capaci-thor/Mecanismos/README.md

# Mecanismos
Resolución de un mecanismo de palancas articuladas para regular la longitud del punto de una máquina de coser.
