capaci-thor/Mecanismos/REPORTE/Proyecto Final Mecanismos.pdf

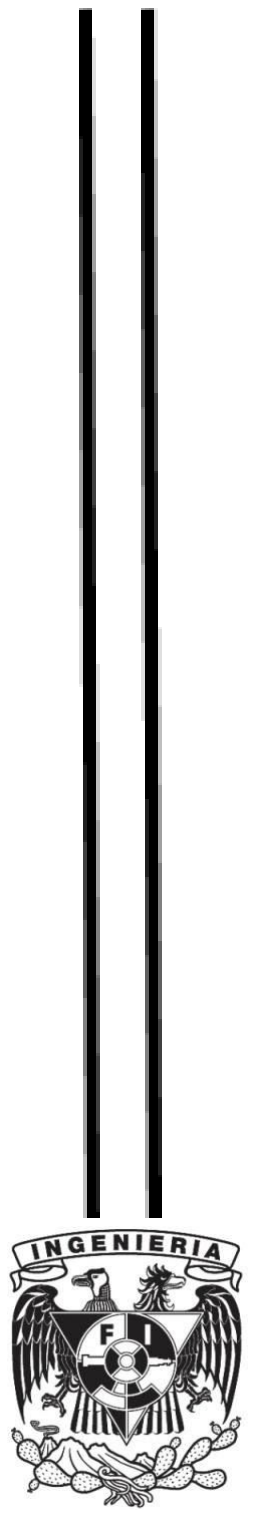
[picture p1: figure]

# Mecanismo de palancas articuladas para regular la longitud del punto de una máquina de coser

### Proyecto Final de Mecanismos

### Integrantes Ortega Trejo José Eduardo Jaimes Arriaga Donovan Zuriel

### Profesor Dr. José Antonio Silva Rico

Ciudad de México, México. 18 de junio de 2020

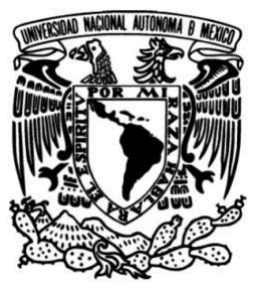
[picture p2: figure]

Objetivos

- Presentar un estudio sobre las posibles aplicaciones del mecanismo, y justificar las variables de control y las fuerzas externas
- Realización del análisis de las variables, grados de libertad e incógnitas del mecanismo.
- Desarrollo en Mathematica de un mecanismo de palancas articuladas para regular la longitud de del punto de un máquina de coser, incluyendo la solución cinemática, dinámica (Trabajo virtual y método de Newton-Euler) para todo rango de movimiento y la simulación del mecanismo.
- Realización del diseño asistido por computadora (CAD) para cada pieza que lo conforma, su ensamble y animación.

Antecedentes

La excéntrica circular 1, que gira alrededor del eje fijo A, se forma un par de rotación B con el elemento 3. El elemento 4 posee un casquillo ensanchado d que abraza la excéntrica 1. El elemento 5, que gira alrededor del eje fijo D, forma los pares de rotación E y F con los elementos 3 y 6. Los elementos 4 y 6 forman un par de rotación G. La excéntrica 1 es solidaria con el elemento 2 en la ranura b del cual puede deslizarse y fijarse la articulación B, gracias a lo cual se cambia la longitud AB. Al girar la excéntrica 1, los dientes a describen una curva de biela x si AB = AC, una curva x1 si AB > AC, y una curva x2 si AB = 0. En el último caso la longitud del punto es igual a cero.

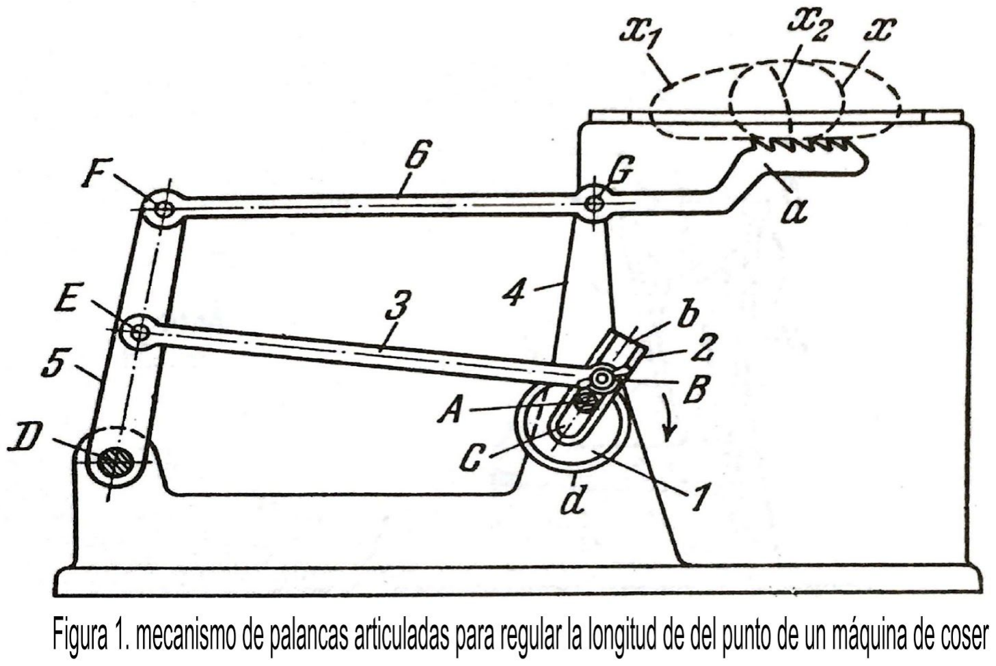
[picture p3: figure]

Para el mecanismo se puede ocupar para diferentes aplicaciones, algunas de ellas son:

- Sujetar un objeto en una posición “1” y colocarlo o pasar por la posición “2”, y esta posición puede ser variable dependiendo el objeto o la distancia a recorrer.

Ejemplos:

1. Recoger algún producto (puede ser una taza ) en la posición “1” y dejarlo en la posición “2”, la distancia entre los productos puede ser variable dependiendo la necesidad.
2. Regular la longitud de un punto de una máquina de coser.
- Otra manera de poder usar este mecanismo es poder usar las diferentes áreas variables que deja el rastro del mecanismo.

Ejemplos:

1. Pintar algún producto (puede ser una caja de cartón) que pasen de manera constante y que el área o el contorno pintado sea variable dependiendo la necesidad.
2. También se puede ver como un limpiaparabrisas que puede limpiar áreas variables para la comodidad del conductor.

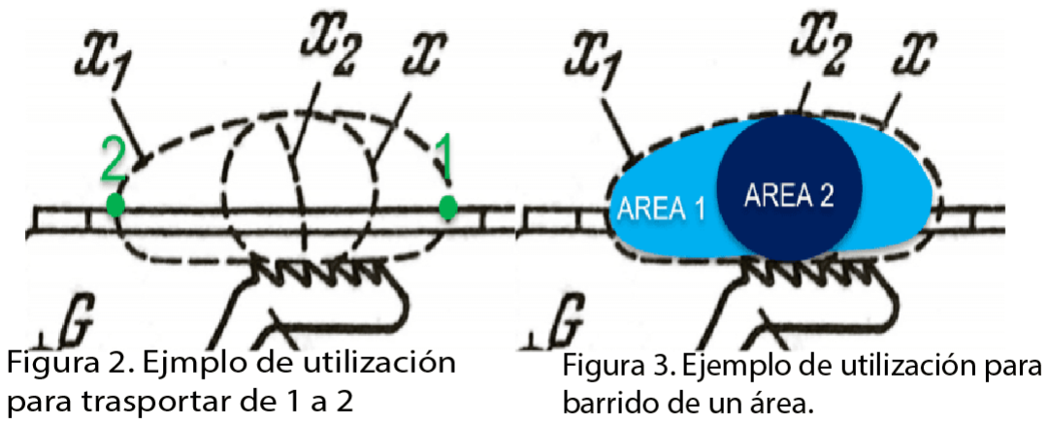
[picture p4: figure]

Para nuestro caso usaremos la aplicación que estaba propuesta desde un inicio “Mecanismo de palancas articuladas para regular la longitud del punto de una máquina de coser”.

## Desarrollo

Planteamiento

Primero se realizó el cálculo de los Grados de Libertad.

L = 6 (número total
de | eslabones,
incluyendo la tierra)

J1 = 7 (número total
de juntas completas)

J2 = 0 (número de
semijuntas)

GDL = 3*(L - 1) -
2*J1 - J2

GDL= 1.

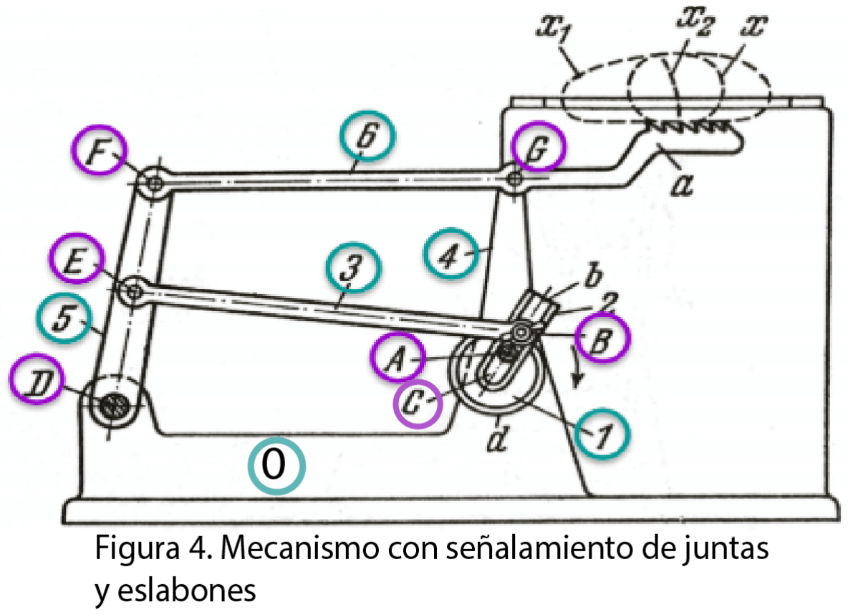
[picture p5: figure]

Como se tiene un grado de libertad, el mecanismo únicamente tiene una entrada, lo más conveniente es que ingrese un par directamente al punto A.

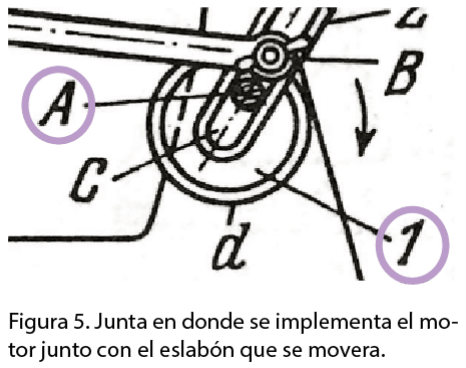
[picture p6: figure]

Para que gire el mecanismo es necesario ingresar un motor que es el que le dará todo el funcionamiento al mecanismo

## Análisis cinemático

Se realizó el lazo vectorial además del diagrama con sus respectivas variables, denotando 8 vectores de posición. Originalmente solo se tienen 7 eslabones pero se debe considerar un vector de posición más porque de no ponerlo, al momento de obtener un lazo vectorial no cerraría la trayectoria y los resultados podrían ser incongruentes.

En la Figura 6 se muestran los vectores que se tomaron en cuenta para la resolución del problema.

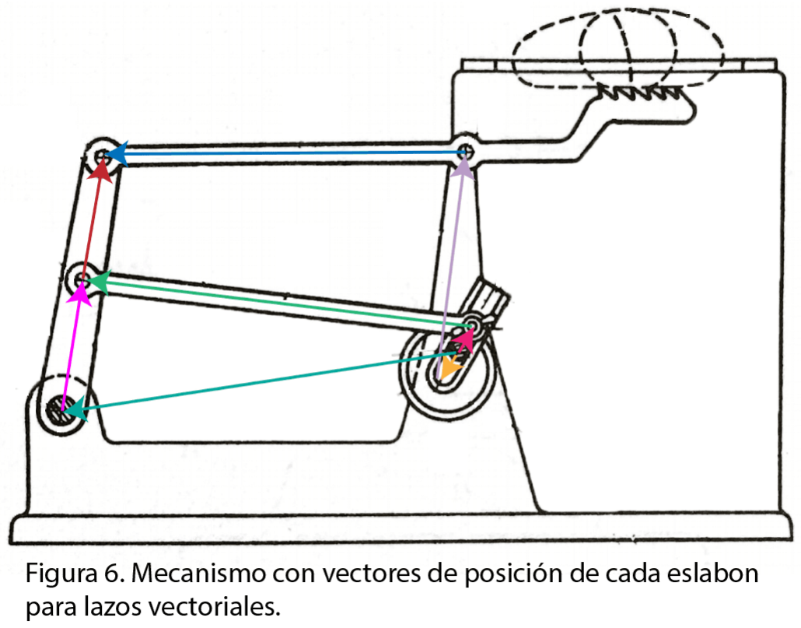
[picture p7: figure]

Se le da un nombre a cada vector para poder saber de cual se estará abordando el problema.

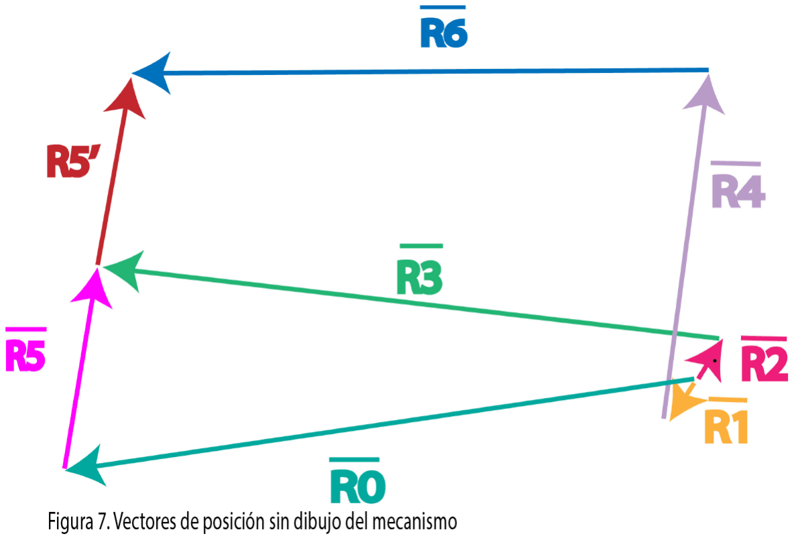
[picture p8: figure]

RO es un caso 0, ya que son vectores de magnitud y orientación fija.

R1

, R2´

, R3

, R4´

, R5

, R5

′ , R6 son caso 2, ya que son vectores de magnitud fija y orientación variable.

Obteniendo los vectores:

R | 0.13(Cos[ | + Sen[190°] ) 0 = | 190°]i

︿
j

︿

R | 0.008(Cos[ | + Sen[ | ] ) 1 = | θ | 180]i 2 +

︿
θ2 + 180 j

︿

R | 0.008(Cos[ | + Sen[ ] ) 2 = | θ ]i 2

︿
θ2

j

︿

R | 0.125(Cos[ | + Sen[ ] ) 3 = | θ ]i 3

︿
θ3

j

︿

R | 0.007(Cos[ | + Sen[ ] ) 4 = | θ ]i 4

︿
θ4

j

︿

R | 0.04 (Cos[ | + Sen[ ] ) 5 = | θ ]i 5

︿
θ5

j

︿

R | 0.04 (Cos[ | + Sen[ ] ) 5
′ = | θ ]i 5

︿
θ5

j

︿

R | 0.115(Cos[ | + Sen[ ] ) 6 = | θ ]i 6

︿
θ6

j

︿

Para la elección de los lazos vectoriales se decidió buscar caminos donde se utilizaran todos los vectores. De los vectores se tienen 5 incógnitas, sin embargo y dado al análisis en el grado de libertad se sabe que se debe de tener una variable de control, en este caso se eligió la variable θ2.

Se proponen los siguientes lazos vectoriales:

POS 1= R + | - | - 2 | R3 | R5 | RO
[1]
POS 2= R + | + | - | - | - 1 | R4 | R6 | R5
′ R3 | R2

[2]

De igual forma para la velocidad:

VEL 1= V + | - | - 2 | V 3 | V 5 | V O | [3]
VEL 2= V + | + | - | - | - 1 | V 4 | V 6 | V 5
′ V 3 | V 2

[4]

Y la aceleración:

ACE 1= A + | - | - 2 | A3 | A5 | AO | [5]
ACE 2= A + | + | - | - | - 1 | A4 | A6 | A5
′ A3 | A2

[6]

Lazo vectorial 1 formado por la ecuación [1] se muestra en la figura 8

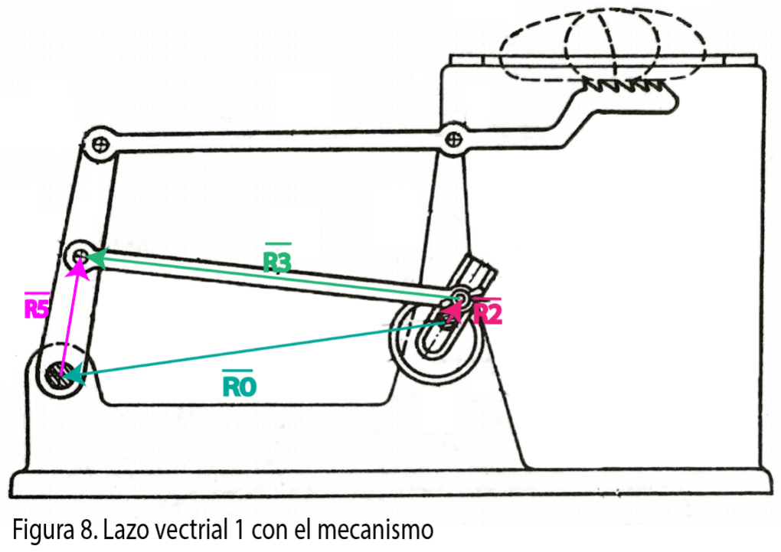
[picture p9: figure]

Lazo vectorial 2 formado por la ecuación [2] se muestra en la figura 9

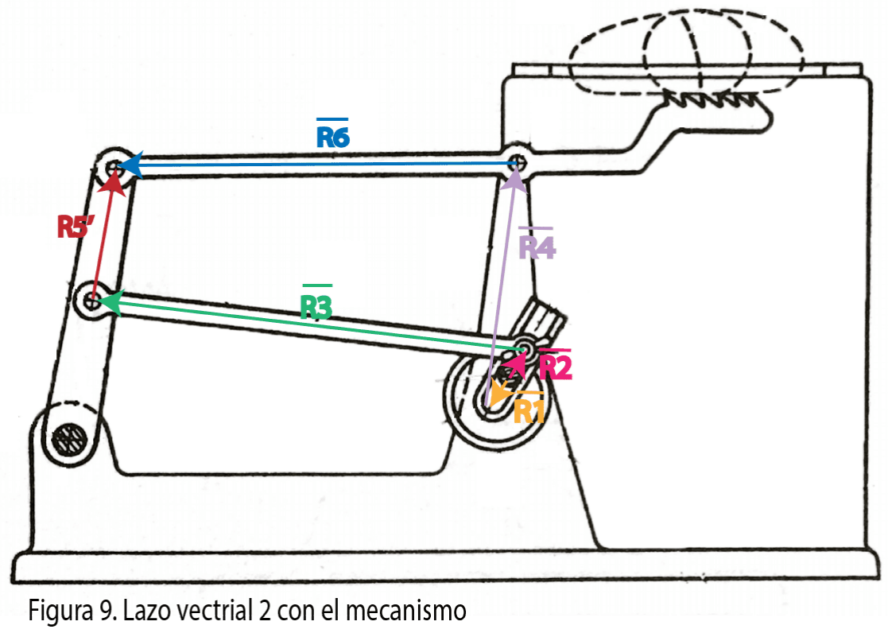
[picture p10: figure]

Por lo tanto, las incógnitas a encontrar en el sistema son: θ , | , | , 3 | θ4 | θ5 | θ6
Para la velocidad se tendrá que calcular: ω , | , | , 3 | ω4 | ω5 | ω6
Para la aceleración: α , | , | ,

´
3
α4 | α5 | α6

El método para la obtención de nuestro sistema de ecuaciones 4 x 4 se realizará con el programa Wolfram Mathematica que tiene su propio intérprete para su lenguaje de programación totalmente con total implementación para áreas científicas, de ingeniería, matemática y áreas computacionales.

Solución de posición

Wolfram Mathematica tiene un función para poder resolver sistemas de ecuaciones simultáneas no lineales, esta función se llama FindRoot, y utiliza el método numérico con newton raphson. Haciendo la implementación de este método, se necesitan valores semilla, que para este caso se proponen ángulos aproximados en los que podría estar nuestro eslabón.

Para la solución inicial, se propuso que el eslabón 2 este en un ángulo de θ = 60°, por 2 lo que para obtener todas las posibles soluciones en un giro completo del elemento A, se tomarán valores de θ con un rango de 60° a 420° 2

Para obtener la solución inicial, se tomó en cuenta un ángulo aproximado de los demás eslabones, proponiendo para la resolución:

θ = 170° 3

θ = 80° 4

θ = 80° 5

θ = 180° 6

Obteniendo una solución general para cada eslabón de:

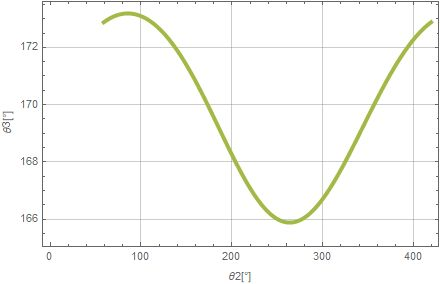
[picture p11: figure]

En la gráfica anterior se puede observar como la orientación del eslabón 3 no cambia mucho, su rango de orientación es 166 θ3 173° con diferencia de movimiento es apenas ≈7°

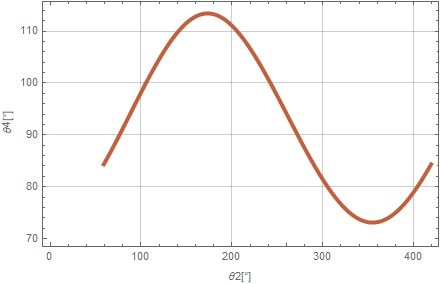
[picture p12: figure]

La gráfica del eslabón 4 se muestra el comportamiento de este oscila entre 75° θ 111°, lo que muestra que la diferencia de movimiento es apenas ≈36° 4

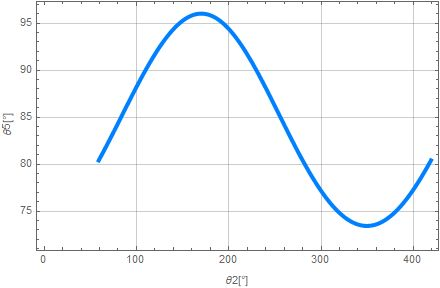
[picture p13: figure]

La gráfica del eslabón 5 nos muestra como varía su posición en un rango de 73° θ 96°, con un movimiento de ≈23° 4

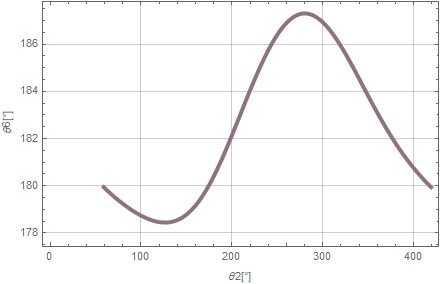
[picture p14: figure]

La gráfica del eslabón 6 nos muestra como varía su posición en un rango de 178° θ 187°, con un movimiento de ≈9° 6

El análisis de las posiciones de los eslabones nos demuestra que ningún eslabón da una vuelta completa, todos los eslabones oscilan entre un rango. El eslabón con una diferencia de movimiento mayor es de ≈ 36°.

θ | Valor Máximo [°] | Valor Mínimo [°]
θ3 | θ ≈173 cuando θ ≈90° 3 2 | θ ≈166 cuando θ ≈270° 3 2
θ4 | θ ≈75 cuando θ ≈170° 4 2 | θ ≈111 cuando θ ≈350° 4 2
θ5 | θ ≈73 cuando θ ≈170° 5 2 | θ ≈96 cuando θ ≈350° 5 2
θ6 | θ ≈178 cuando θ ≈130° 6 2 | θ ≈187 cuando θ ≈280° 6 2

Con esta tabla se puede concluir que el eslabón 3 alcanza su mayor ángulo cuando θ2 esta en su punto más alto y su menor ángulo cuando el eslabón 2 se encuentra en su menor posición. Respecto a los eslabones 4 y 5 se comportan de manera muy similar ya que alcanzan su mayor y menor ángulo casi al mismo tiempo.

Para el eslabón 6 se comporta de manera distinta a los demás, los anteriores alcanzaban sus ángulos máximos y mínimos en un rango de 180°. pero este no.

Solución de velocidad

Para la soluciones de velocidad del mecanismo,de igual manera, se propuso un valor. En este caso se eligió el valor de ω2 = 50 [rad/seg] , esto para tener una velocidad aproximada de 477.5 RPM. Wolfram Mathematica, tiene una función para resolver funciones lineales llamado Solve, puesto que se conoce ya la posición de cada eslabón se vuelve lineal, por lo tanto ahora no necesitamos un valor semilla para cada eslabón. Obteniendo las velocidades de los eslabones se tiene que:

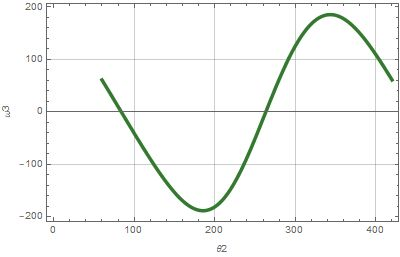
[picture p15: figure]

En la gráfica de velocidad para el eslabón 3 se puede observar como la velocidad nunca se mantiene constante, siempre esta variando pero de una forma constante, muy similar a una función sinusoidal.

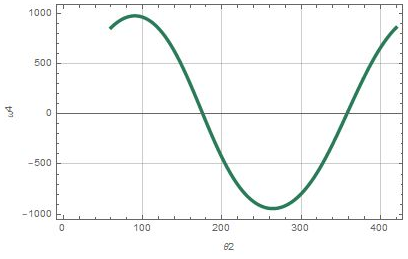
[picture p16: figure]

En la gráfica de velocidad para el eslabón 4 se puede observar como la velocidad nunca se mantiene constante, y de igual forma que el eslabón 3 se parece a una función sinusoidal pero con una amplitud mayor porque las crestas y valles se perciben más separados.

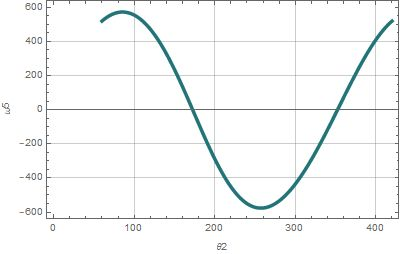
[picture p17: figure]

El eslabón 5, de la misma forma parece que proviene de una función sinusoidal por su comportamiento.

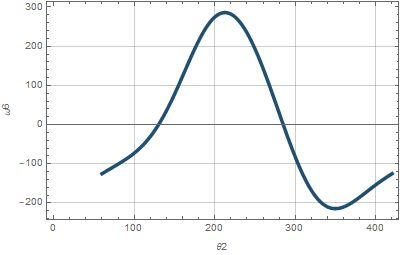
[picture p18: figure]

A diferencia de las velocidades de los eslabones 3, 4 y 5, el eslabón 6 si tiene una gran diferencia en como la velocidad cambia poco a poco y después un poco más rápido.

ω | Valor Máximo [rad/s] | Valor Mínimo [rad/s]
ω3 | ω ≈180 cuando θ ≈180° 3 2 | ω ≈ 80 cuando θ ≈340° 3 − 1 2
ω4 | ω ≈1000 cuando θ ≈90° 4 2 | ω ≈ 000 cuando θ ≈260° 4 − 1 2
ω5 | ω ≈600 cuando θ ≈90° 5 2 | ω ≈ 00 cuando θ ≈260° 5 − 6 2
ω6 | ω ≈280 cuando θ ≈210° 6 2 | ω ≈ 10 cuando θ ≈350° 6 − 2 2

Con esta tabla se puede concluir que el eslabón 3 alcanza su mayor velocidad cuando θ2 esta de manera horizontal y su menor ángulo cuando el eslabón 2 se encuentra nuevamente cerca de la horizontal.

Respecto a los eslabones 4 y 5 se comportan de manera muy similar ya que alcanzan su mayor y menor velocidad casi al mismo tiempo, y esto sucede cuando θ2 se encuentra en su mayor y menor posición.

Para el eslabón 6 en la velocidad también se comporta de manera distinta a los demás, los anteriores alcanzaban sus ángulos máximos y mínimos en un rango de 180°. pero este no.

Solución de aceleración

Para la solución de la aceleración se propuso que α2 = 0 [ rad/seg ] , debido a que lo deseable es que nuestra manivela no se acelere, esto porque entre más rápido gire, también aumentan las aceleraciones de los eslabones y por ende también las fuerzas. Si girara demasiado rápido, podrían darse deformaciones en las juntas o que simplemente se rompa. Estas ecuaciones, de igual forma resueltas en Wolfram mathematica se resuelven con la misma función Solve. Obteniendo las siguientes gráficas para todas las posiciones de θ2

, se obtienen las siguientes gráficas

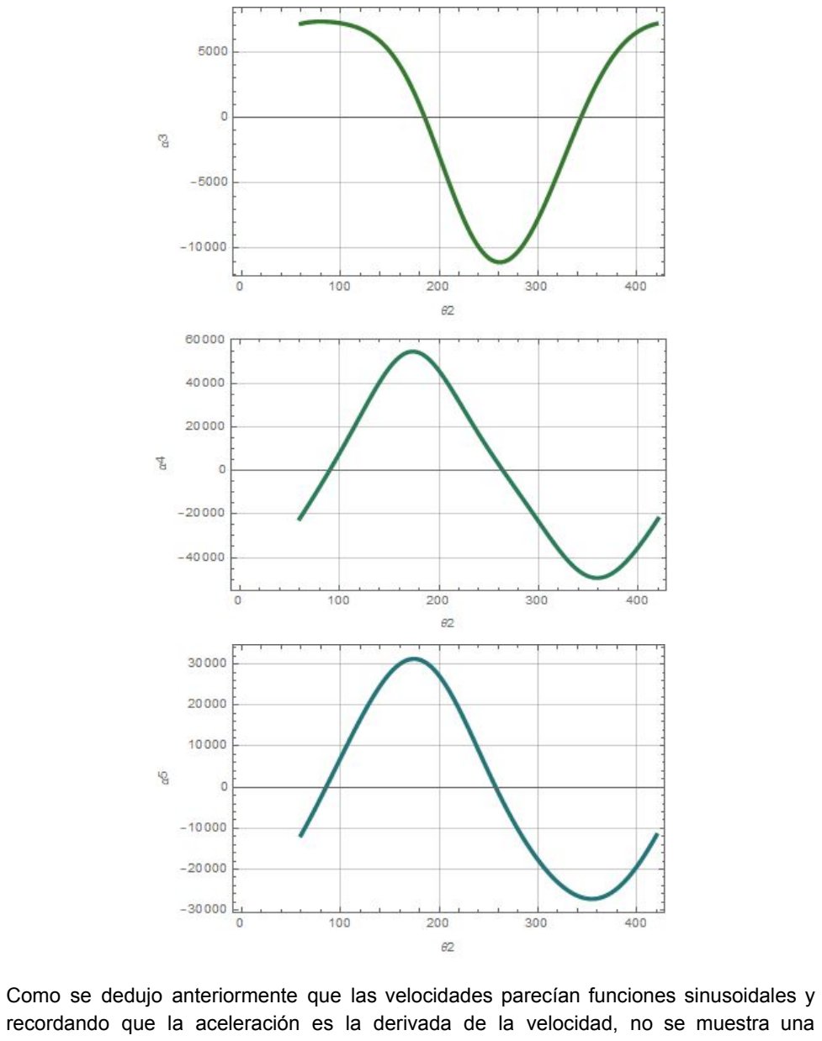
[picture p19: page 16]

Como se dedujo anteriormente que las velocidades parecían funciones sinusoidales y recordando que la aceleración es la derivada de la velocidad, no se muestra una incongruencia al mostrar que las aceleraciones de igual forma, sean funciones sinusoidales.

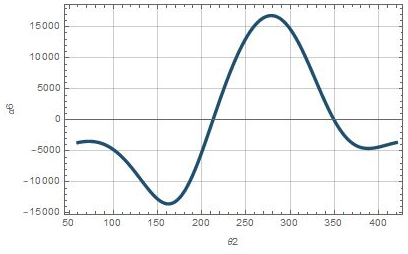
[picture p20: figure]

La aceleración del eslabón 6, es la más rara pues representada por una velocidad, que de igual forma es rara, se tiene que al principio del mecanismo se muestra una pequeña aceleración, seguido de una considerable desaceleración y después una gran aceleración que termina en una desaceleración para volver a repetir el las aceleraciones.

α | Valor Máximo [ rad ] s 2 | Valor Mínimo [ rad ] s 2
α3 | α ≈8000 cuando θ ≈90° 3 2 | α ≈ 1000 cuando θ ≈260° 3 − 1 2
α4 | α ≈55000 cuando θ ≈170° 4 2 | α ≈ 0000 cuando θ ≈360° 4 − 5 2
α5 | α ≈32000 cuando θ ≈170° 5 2 | α ≈ 6000 cuando θ ≈360° 5 − 2 2
α6 | α ≈17000 cuando θ ≈275° 6 2 | α ≈ 4000 cuando θ ≈165° 6 − 1 2

Con esta tabla se puede concluir que el eslabón 3 alcanza su mayor aceleración positiva cuando el eslabón 2 está vertical y su menor aceleración cuando el eslabón 2 se encuentra nuevamente vertical dirigido hacia abajo.

Respecto a los eslabones 4 y 5 se comportan de manera muy similar ya que alcanzan su mayor y menor aceleración casi al mismo tiempo, y esto sucede cuando el eslabón 2 se encuentra de manera horizontal.

Para el eslabón 6 en la aceleración también se comporta de manera distinta a los demás, los anteriores alcanzaban sus ángulos máximos y mínimos en un rango de 180°. pero este no.

Modelo 3D

Para el desarrollo del programa en Mathematica con el Método de Newton y el de potencia se tiene que realizar el diseño de los eslabones mediante el uso de software de diseño.

Esto debido a que para poder realizar el análisis dinámico se requiere de información como los centros de gravedad, los momentos de inercia y las masas de cada pieza.En el programa, mediante el análisis cinemático, se determinaron los parámetros como el largo de los eslabones, y sus posiciones en el espacio. Con esto se obtuvo un diseño que consistió en las siguientes piezas:

Eslabón 1:

Eslabón 2:

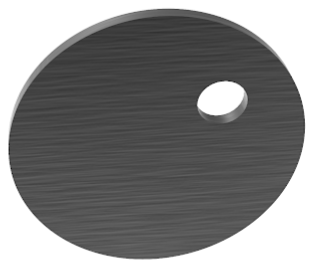
[picture p21: figure]

Eslabón 3:

Eslabón 4:

Eslabón 5:

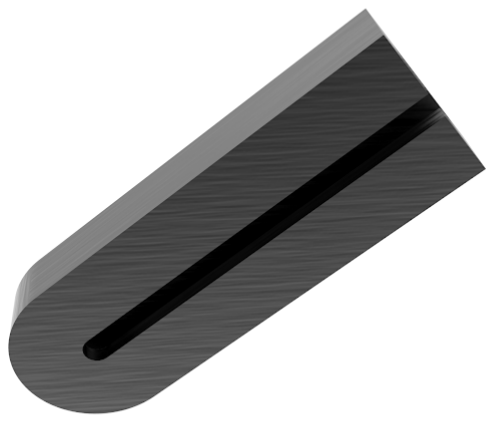
[picture p22: figure]
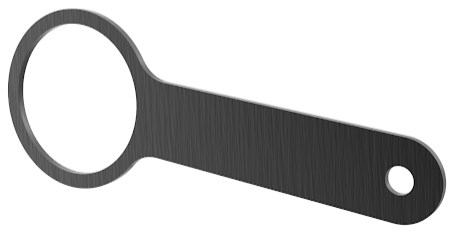
[picture p23: figure]

Eslabón 6:

Tierra :

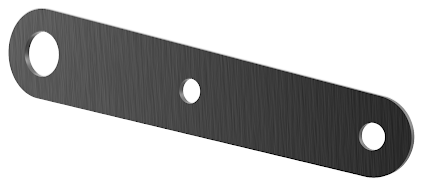
[picture p24: figure]
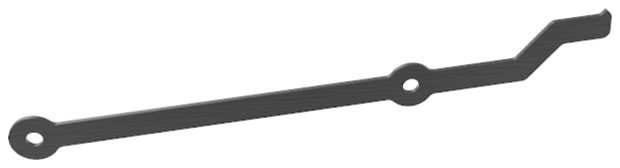
[picture p25: figure]

Ensamble:

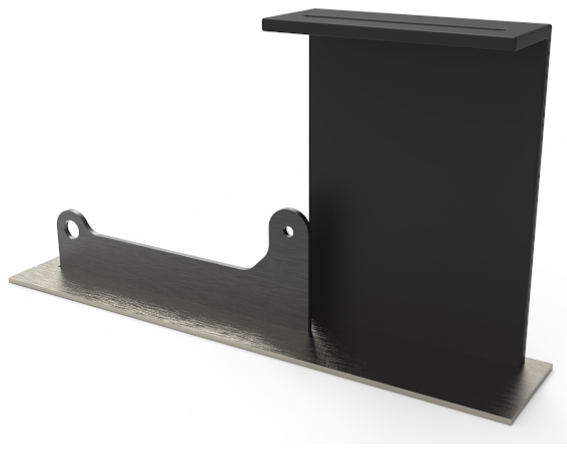
[picture p26: figure]
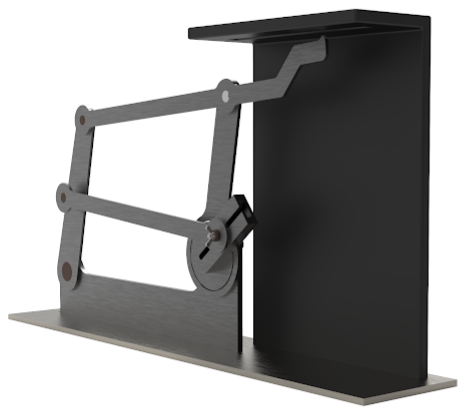
[picture p27: figure]

Análisis Dinámico

El método para el análisis dinámico requiere de información como lo son masa y momento de inercia, de los cuales se obtuvieron los siguientes datos:

Eslabón | Masa[Kg] | IG[g/mm ] 2
1y2 | 0.02772 | 8061.84
3 | 0.01433 | 25654.01
4 | 0.01402 | 10118.87
5 | 0.01824 | 13175.67
6 | 0.01917 | 72531.46

Para la obtención de los momentos de inercia en los centros de masa de cada una de las piezas, se utilizaron los valores proporcionados por Solidworks, los cuales se muestran a través de tensores. Los tensores para cada pieza se expresan de la siguiente manera:

IXX | IXY | IXZ
IYX | IYY | IYZ
IZX | IZY | IZZ

Los momentos de inercia son medidos desde el sistema de coordenadas de salida y las unidades son [ gr/mm ]. En todos los casos, todas las piezas fueron 2 diseñadas ² utilizando como referencia el plano XY, por lo tanto, el momento de inercia requerido es la componente Izz

Eslabón 1 y 2:

Eslabón 3:

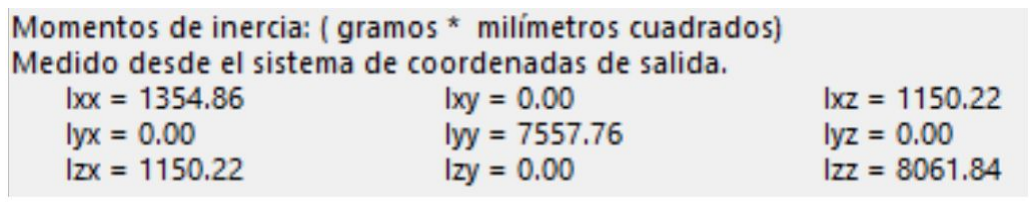
[picture p28: figure]

Eslabón 4:

Eslabón 5:

Eslabón 6:

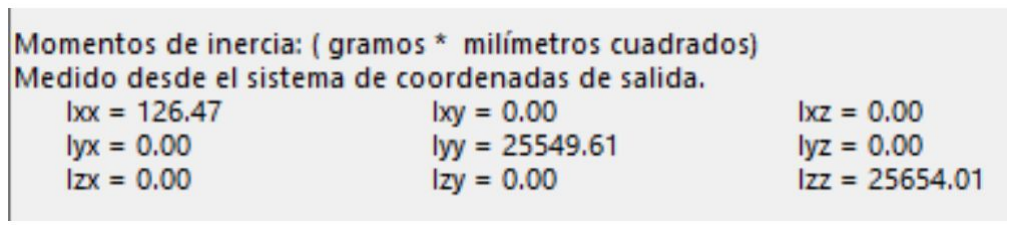
[picture p29: figure]
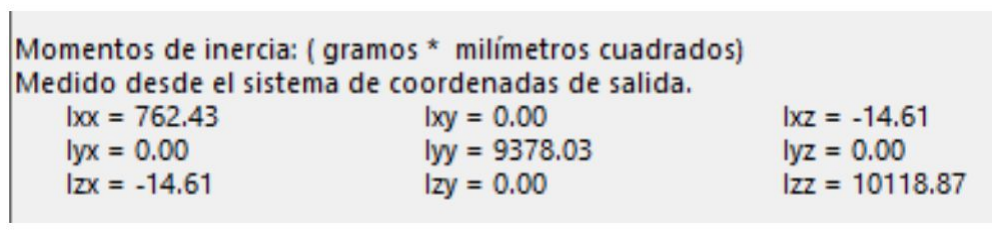
[picture p30: figure]
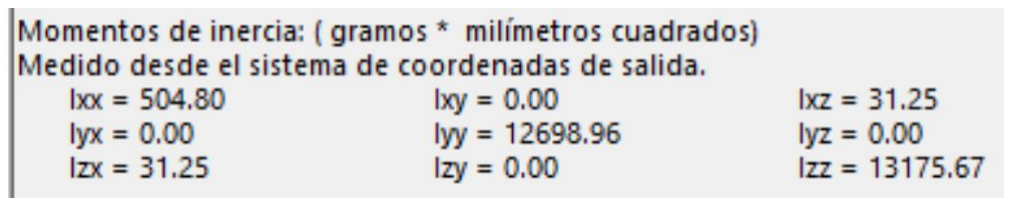
[picture p31: figure]
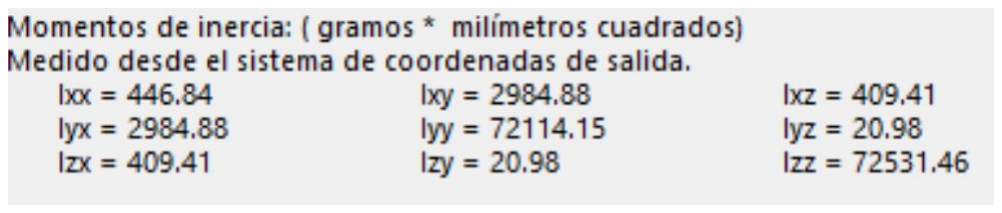
[picture p32: figure]

Cabe mencionar que los eslabones están hechos con Acero A36 pues es uno de los aceros más comunes.Por sus propiedades mecánicas, ya que siendo un mecanismo del cual no se necesita unas mayores características de resistencia mecánica, parece un material sencillo y fácil de conseguir.

Dinámica método Newton - Euler

Para la solución dinámica de newton, se necesitan los datos proporcionados anteriormente y en este caso proporcionados por el software de CAD SolidWorks. Para este método, se definieron los vectores como en la solución cinemática con la diferencia de que los vectores ya no serán de junta a junta, ahora estos vectores están definidos por un origen al centro de masa de cada eslabón.

Este método ayuda a la obtención de las fuerzas en cada eslabón, por lo tanto de las siguientes ecuaciones se deben de aplicar para cada eslabón.

∑ F = maG

∑ M α G = IG

Por lo tanto, se debe de tener un análisis completo de todas las fuerzas y pares que intervienen en cada eslabón, a continuación se presentan los diagramas de cuerpo libre de cada eslabón:

Eslabón 1 y 2:

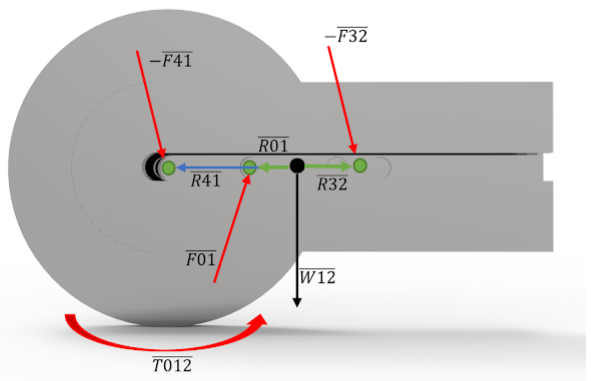
[picture p33: figure]

∑ F = − F | F | a 41 + 01 − F32 − W 12 = m12 G12
∑ M | x | x | R x F | α G = T 012 + R41 | (− F41) + R32 | (− F32) + 01 | 01 = I

G12

2

Eslabón 3:

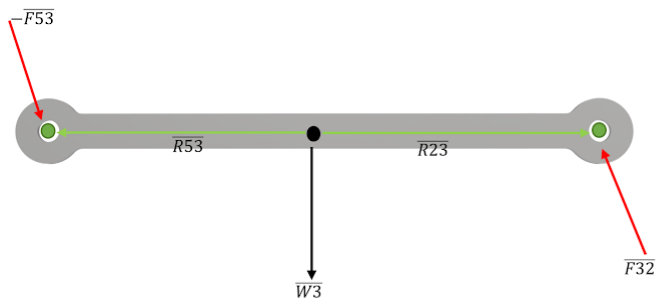
[picture p34: figure]

∑ F = − F | F | a 53 + 32 − W 3 = m3 G3
∑ M | x | R x F | α G = + R53 | (− F53) + 23 | 32 = I

G3

3

Eslabón 4:

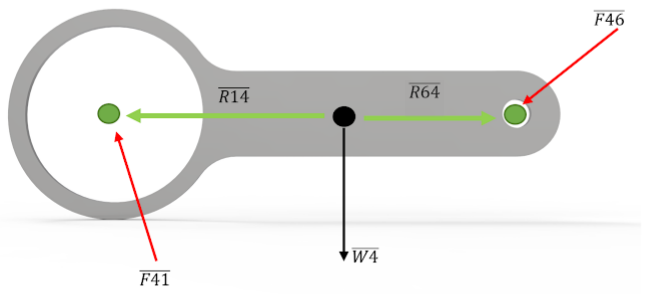
[picture p35: figure]

| ∑ F = F | | | F | a 41 + 46 − W 4 = m4 G4
∑ M | x | x | α G = + R14 | (F41) + R64 | (F46) = I

G4

4

Eslabón 5:

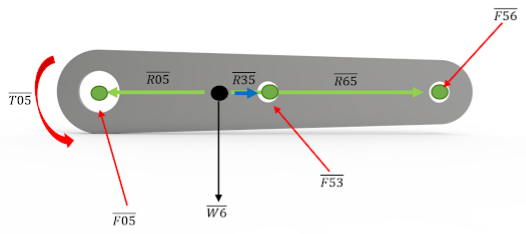
[picture p36: figure]

∑ F = + F | F | a 05 + 53 + F56 − W 5 = m5 G5
∑ M | x | x | R x F | α G = T 05 + R05 | (F05) + R35 | (F53) + 65 | 56 = I

G5

5

Eslabón 6:

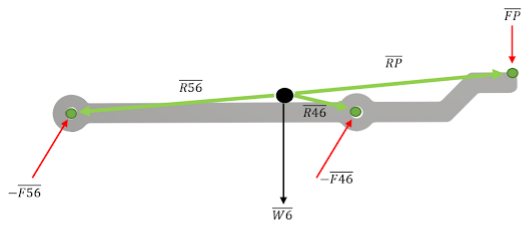
[picture p37: figure]

∑ F = − F | F | a 56 + P − F46 − W 6 = m6 G6
∑ M | + | x | x | R x F | α G = R56 | (− F56) + R46 | (− F46) + P | P = I

G6

6

En las imágenes anteriores, se muestran las fuerzas de reacción que interactúan en cada uno de los eslabones, donde tenemos como incógnitas todas las fuerzas, excepto FP , que fue un dato de entrada.

Solución método de Newton con masa

El planteamiento con las ecuaciones de Newton - Euler nos da como resultado un sistema de ecuaciones lineales de 15 x 15 que con ayuda de Wolfram Mathematica y su función Solve se resolverá.

Solución método de Newton sin masa

Dinámica método de trabajo virtual

El método de para obtener el diferente par que tendrá el motor para poder mover el mecanismo. Este método utiliza la siguiente ecuación:

∑ v

n

k = 2

Fk

•

k + ∑

n

k = 2

T | a | α k
- ωk − ∑

n

k = 2

mk Gk

- vGk − ∑

n

k = 2

IGk k

- ωk = 0
F | v | T | T | m a | a | m a P
- P + 05
- ω5 + 01
- ω2 | − | 12 G12
- vG12 − m3 G3
- vG3 − 4 G4
- vG4
− m a | a | I α | − I α | − I α 5 G5
- vG5 − m6 G6
- vG6 − G12 2
- ω2 | G3 3
- ω3 | G4 4
- ω4
− I α | − I α G5 5
- ω5 | G6 6
- ω6 | = 0

Este método, tiene la ventaja de obtener el par que necesita el mecanismo para poder moverse, al contrario del método de Newton - Euler, solo se tiene una ecuación de 1 x 1, sin embargo por la gran cantidad de información y porque deseamos obtener los diferentes pares que se necesitan para el mecanismo, se utilizará Wolfram Mathematica para la solución del sistema.

Se planea la ecuación y con la función Solve de Wolfram Mathematica se obtiene el siguiente gráfico del θ vs 2
τ 01z

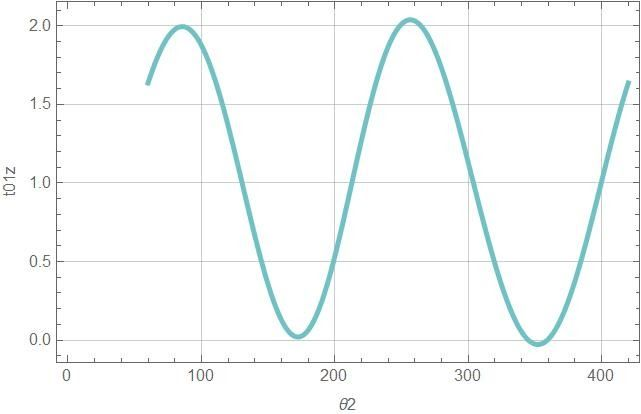
[picture p38: figure]

La gráfica del par parece congruente, no tiene ningún problema de continuidad y de cambios bruscos. Se muestra como va cambiando de forma continua y congruente.

### Comparación de las fuerzas y el torque con y sin considerar el peso en el método de Newton-Euler

Básicamente no hay gran variación entre un caso y el otro, donde la mayor diferencia se encuentra es en las crestas y valles pero sigue sin ser realmente una diferencia significativa:

Las funciones de color naranja son con peso

Las funciones de color verde son sin peso

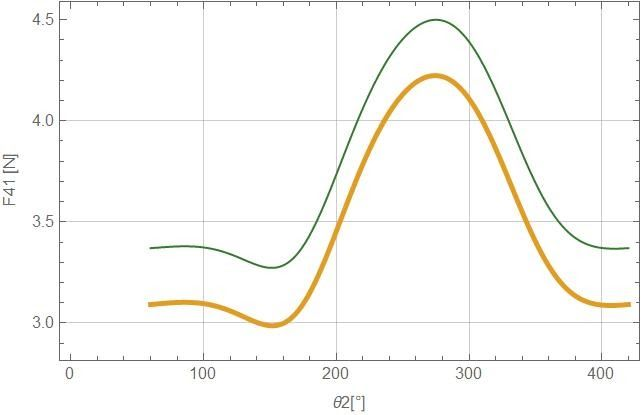
[picture p39: figure]
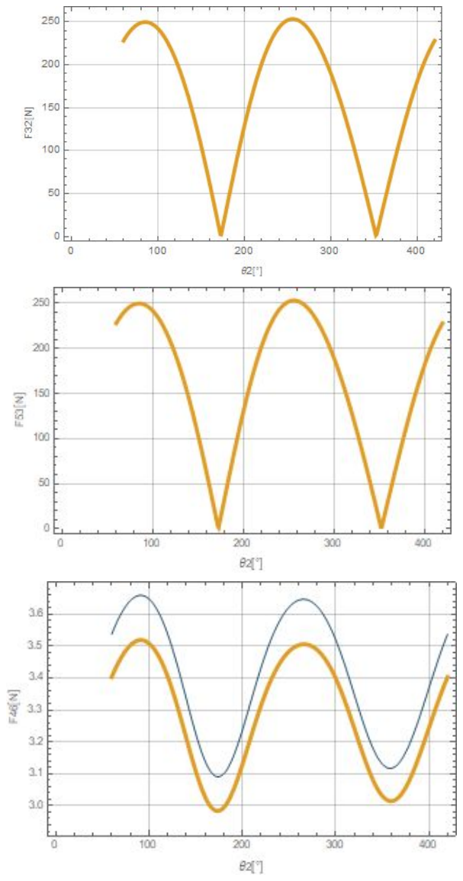
[picture p40: page 30]
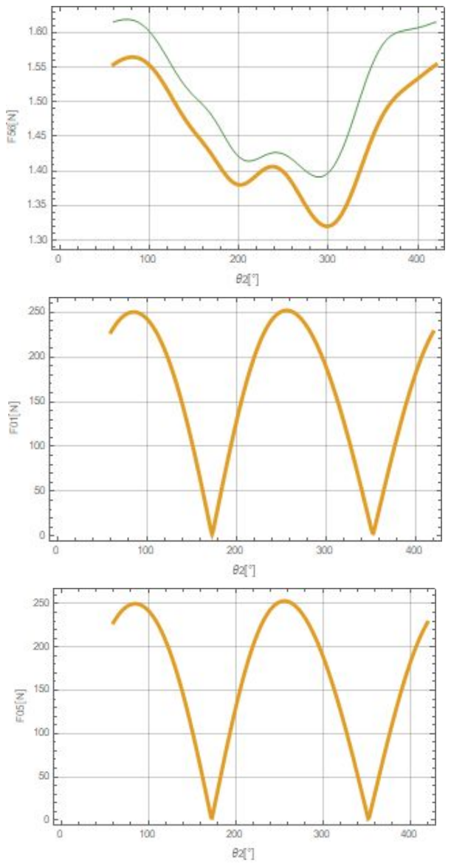
[picture p41: page 31]
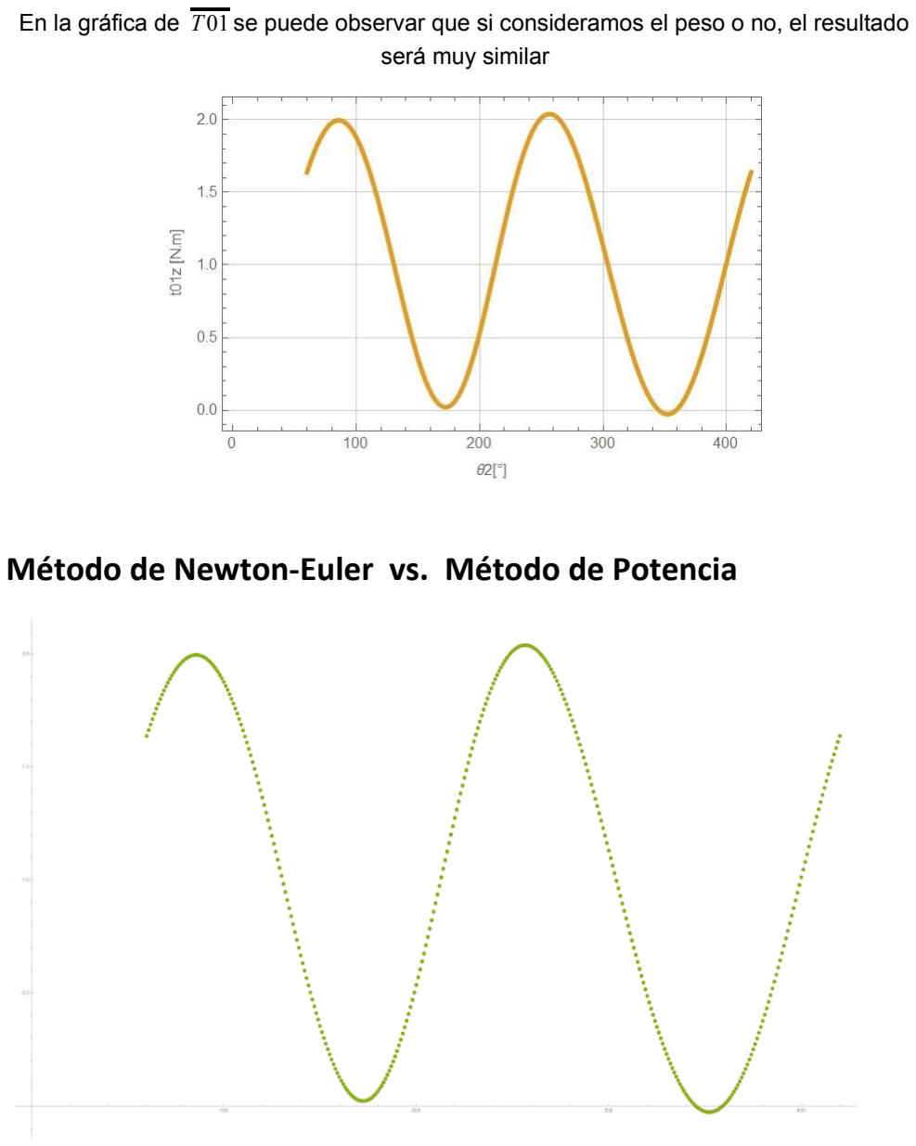
[picture p42: page 32]

En la gráfica de T01 se puede observar que si consideramos el peso o no, el resultado será muy similar

### Método de Newton-Euler vs. Método de Potencia

Podemos ver entre ambos métodos que la aproximación no es 100% exacta, pero es casi la misma, ya que en algunos lugares se puede notar un tona anaranjado la cual le pertenece al método de Newton, ambos métodos ofrecen los mismos resultados de momento dependiendo de la posición de la manivela.

Conclusiones

El análisis cinemático es la base para el total desarrollo de un mecanismo porque da una idea clara y sencilla de interpretar el movimiento de los eslabones dependientes de una variable de entrada, es decir, un solo eslabón controla al mecanismo.

Una simulación con los datos proporcionados con el análisis cinemático y la interpretación de los distintos valores en las posiciones de los eslabones son un indicador de que el procedimiento se está llevando de una manera adecuada.

El principal problema de este mecanismo es que en uno solo se puede decir que incluye 3, pues la corredera que se fija nos permite tener 3 diferentes movimientos, los que dependen de las distintas longitudes que puede tener el eslabón 2.

El análisis Dinámico, depende de un diseño previo de CAD, por lo que es de las cosas más importantes, pues sin este tipo de software nos permite obtener información de propiedades mecánicas del eslabón, como en este caso la masa. Este análisis nos permite obtener la fuerza de cada eslabón, método de Newton - Euler, sin embargo el método de Trabajo virtual nos permite obtener únicamente las fuerza que ingresa al sistema o la fuerza que sale del sistema.

El método Newton - Euler nos da toda la información de fuerzas y pares aplicados al sistema y el método de trabajo virtual, nos da el par de entrada, por lo que hay una comparación pues obtenemos el mismo dato de 2 formas diferentes, como la muestra la gráfica de comparación de par se puede observar que los pares no son totalmente igual pero aún así se parecen demasiado el método de Newton - Euler con peso y el método de trabajo virtual, sin embargo el método de Newton - Euler sin peso se parece a las otros 2 análisis pero son valor absoluto, no muestra valores negativos aunque parece tener el mismo comportamiento que los otros 2 métodos.

Cabe mencionar que también sería bueno un análisis para las otras 2 posibles distancias de del vector R , ya que este análisis fue basado más a la opción en la que AB > AC, 2 aunque el análisis es muy parecido, no se debe dar por hecho y es destacable la opción de añadir los otros 2 análisis.

Se considera que se debería tener un mayor análisis para obtener las resistencias del material para saber si es óptima la y las diferentes fallas por fatiga que este podría tener.

Por último, se propone que para el total análisis del mecanismo, se debería hacer un estudio completo de la resistencia de los materiales, para poder saber si el material propuesto soportaría los esfuerzos a los que estaría sometido.
