capaci-thor/Mecanismos/Mecanismo 13.pdf

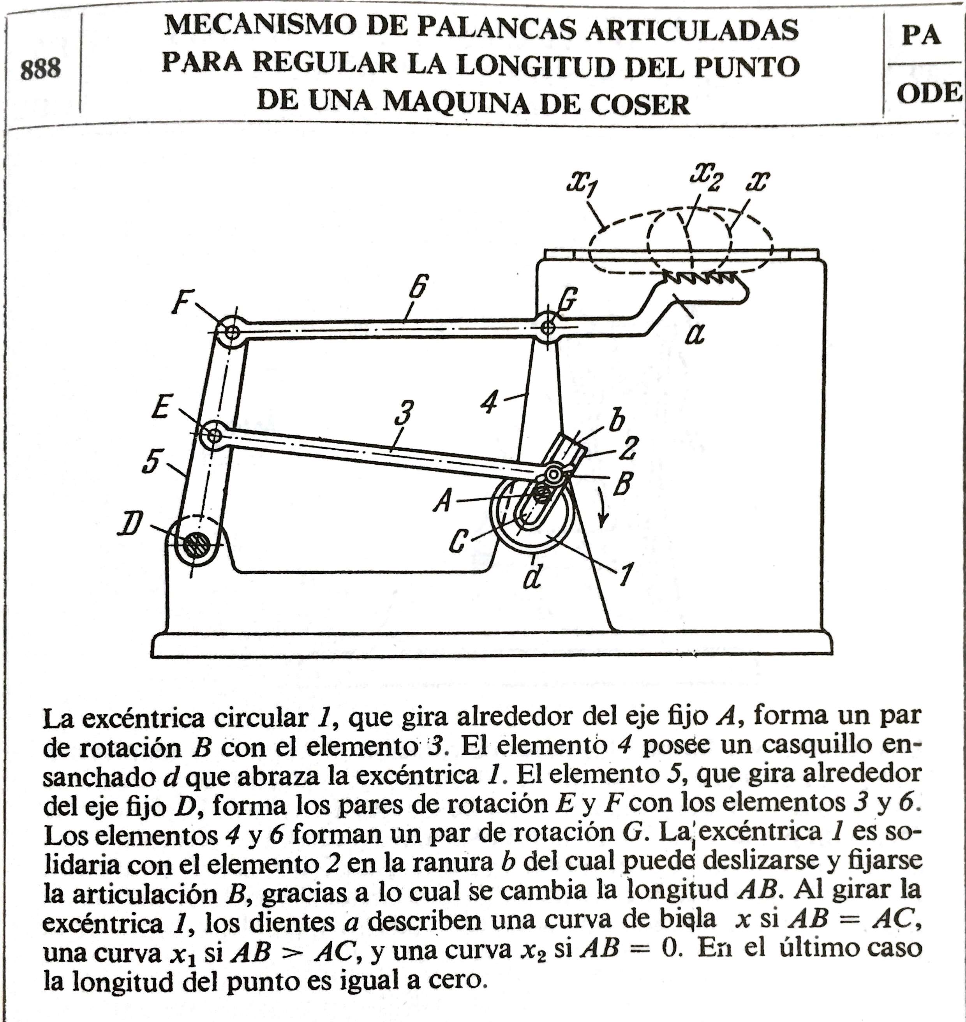
[picture p43: page 1]
