capaci-thor/Mecanismos/Mecanismo 13.png

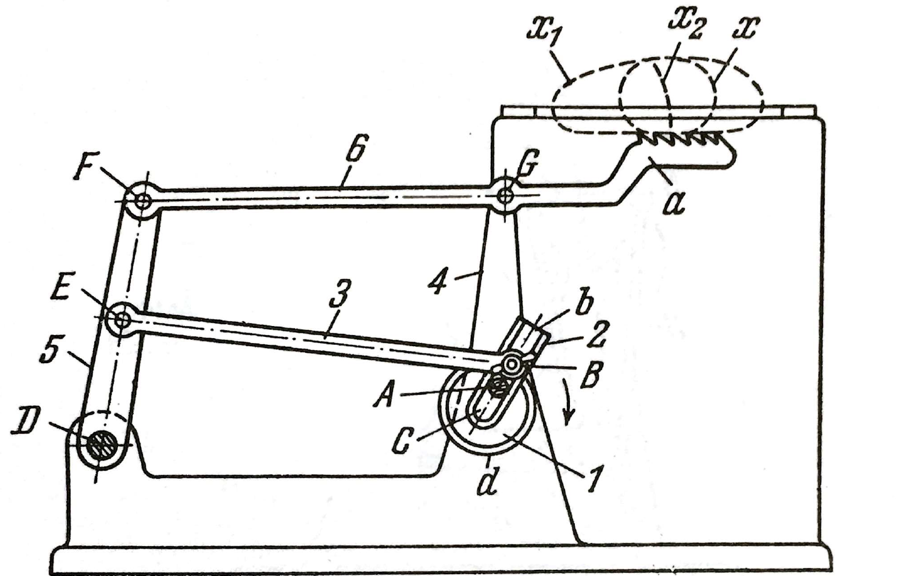
Mecanismo 13.png
