capaci-thor/Mecanismos/MODELO 3D/ANIMACION/RENDERS/Eslabon1.113.png

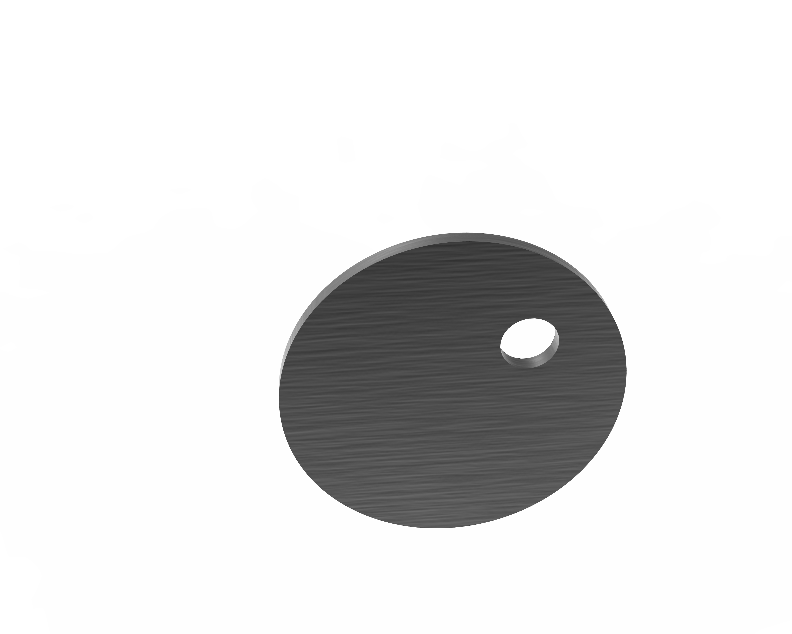
MODELO 3D/ANIMACION/RENDERS/Eslabon1.113.png
