capaci-thor/Mecanismos/MODELO 3D/ANIMACION/RENDERS/Eslabon2.114.png

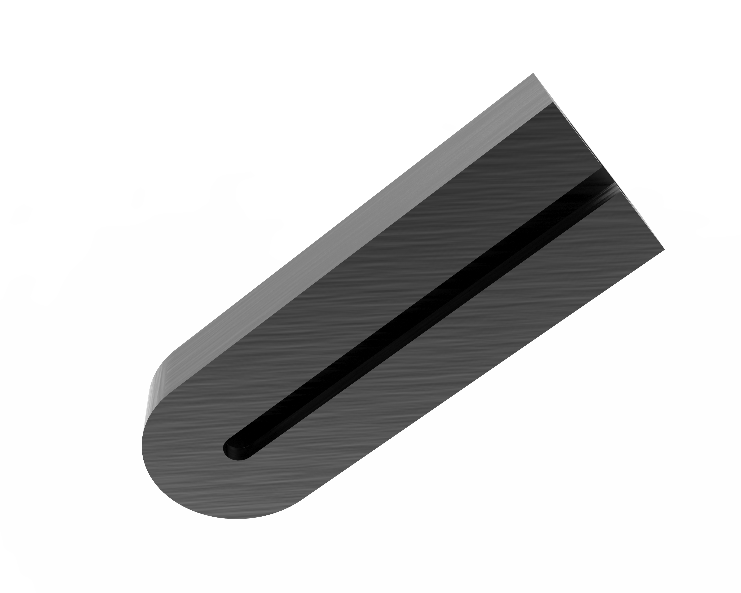
MODELO 3D/ANIMACION/RENDERS/Eslabon2.114.png
