capaci-thor/Mecanismos/MODELO 3D/ANIMACION/RENDERS/Eslabon3.112.png

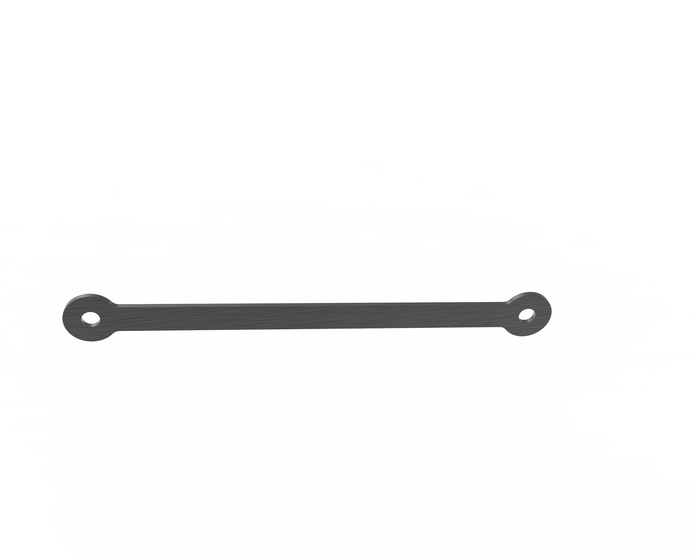
MODELO 3D/ANIMACION/RENDERS/Eslabon3.112.png
