capaci-thor/Mecanismos/MODELO 3D/ANIMACION/RENDERS/Eslabon4.116.png

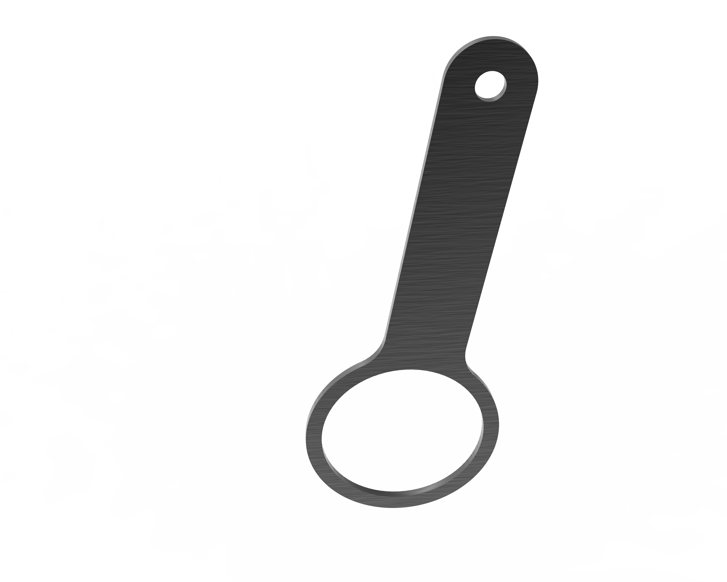
MODELO 3D/ANIMACION/RENDERS/Eslabon4.116.png
