capaci-thor/Mecanismos/MODELO 3D/ANIMACION/RENDERS/Eslabon5.115.png

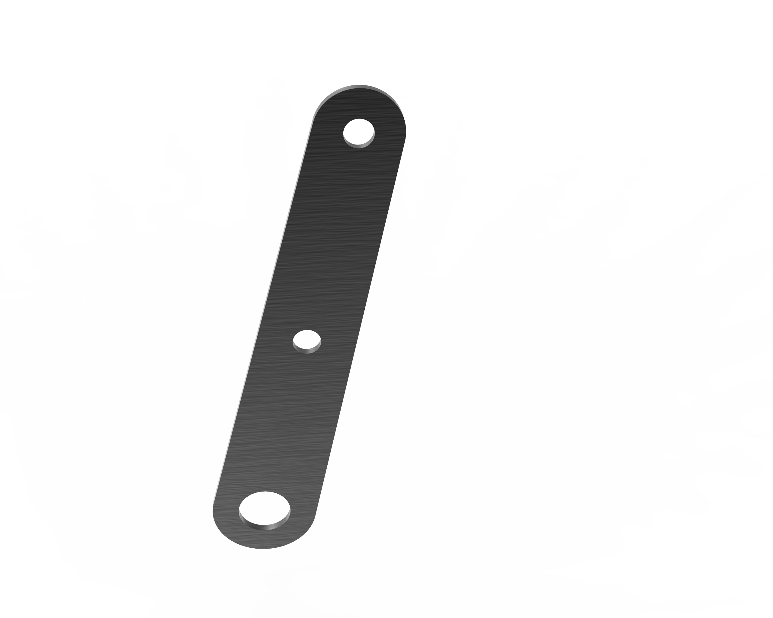
MODELO 3D/ANIMACION/RENDERS/Eslabon5.115.png
