capaci-thor/Mecanismos/MODELO 3D/ANIMACION/RENDERS/Eslabon6.111.png

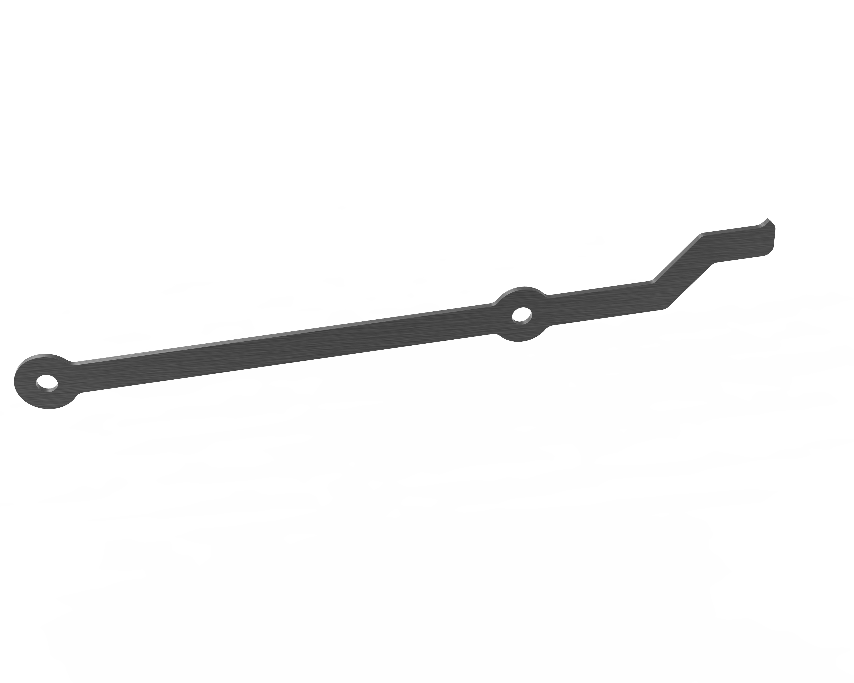
MODELO 3D/ANIMACION/RENDERS/Eslabon6.111.png
