capaci-thor/Mecanismos/MODELO 3D/CAD/.IGES/Ensamble_Parte_Mecanismo_13.IGS

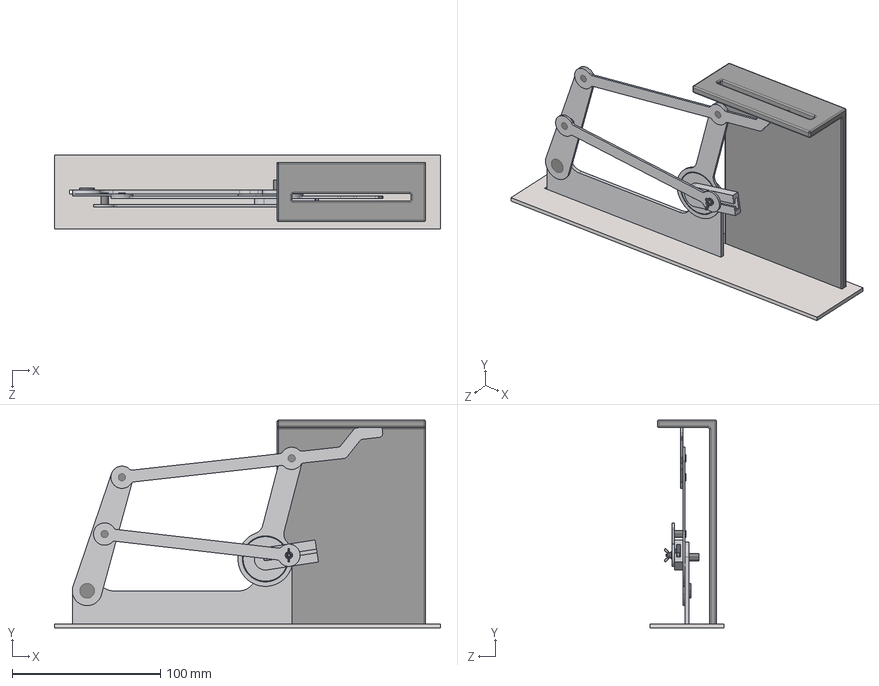
[picture p51: CAD file, 2021-02-01]
MODELO 3D/CAD/.IGES/Ensamble_Parte_Mecanismo_13.IGS
260.0 x 140.0 x 50.0 mm
