capaci-thor/Mecanismos/MODELO 3D/CAD/.IGES/Eslabon_3.IGS

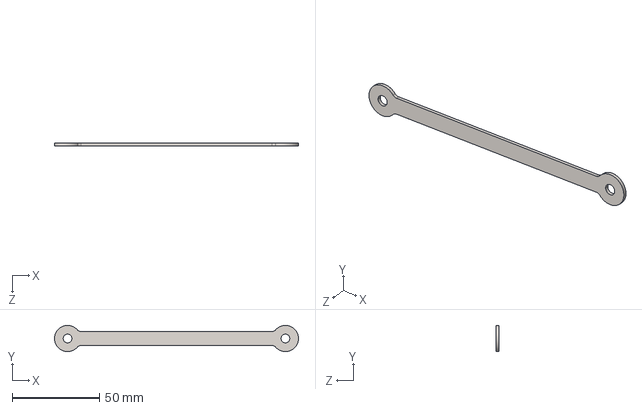
[picture p52: CAD file, 2021-02-01]
MODELO 3D/CAD/.IGES/Eslabon_3.IGS
140.0 x 15.0 x 1.52 mm
