capaci-thor/Mecanismos/MODELO 3D/CAD/.IGES/Arandela_M2.IGS

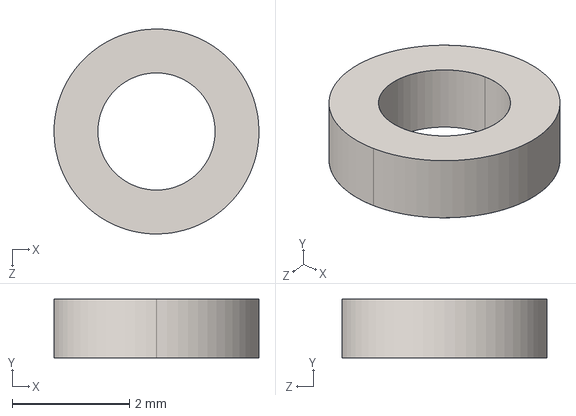
[picture p53: CAD file, 2021-02-01]
MODELO 3D/CAD/.IGES/Arandela_M2.IGS
3.50 x 1.00 x 3.50 mm
