capaci-thor/Mecanismos/MODELO 3D/CAD/.IGES/Tierra_1.IGS

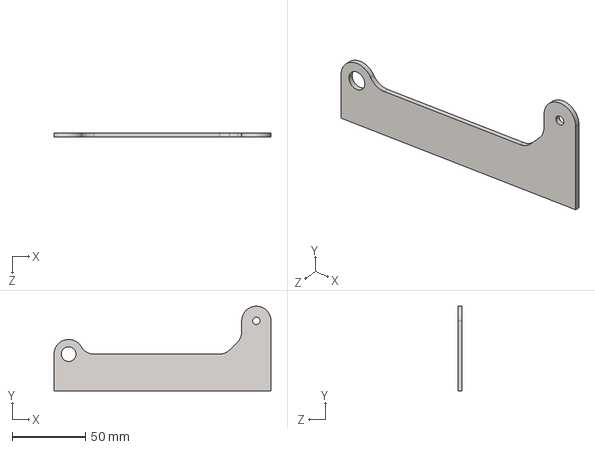
[picture p54: CAD file, 2021-02-01]
MODELO 3D/CAD/.IGES/Tierra_1.IGS
148.0 x 57.7 x 2.66 mm
