capaci-thor/Mecanismos/MODELO 3D/CAD/.IGES/Rodamiento_623-2RS.IGS

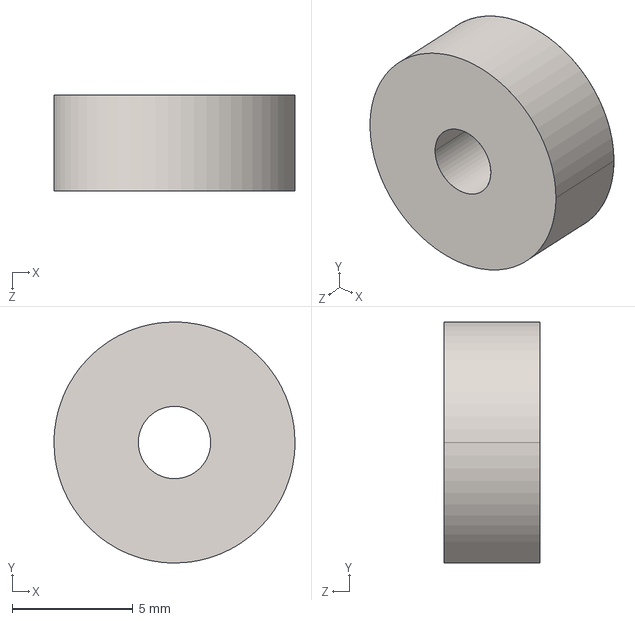
[picture p55: CAD file, 2021-02-01]
MODELO 3D/CAD/.IGES/Rodamiento_623-2RS.IGS
10.0 x 10.00 x 4.00 mm
