capaci-thor/Mecanismos/MODELO 3D/CAD/.IGES/Complemento_Rodamiento_682-ZZ_2.IGS

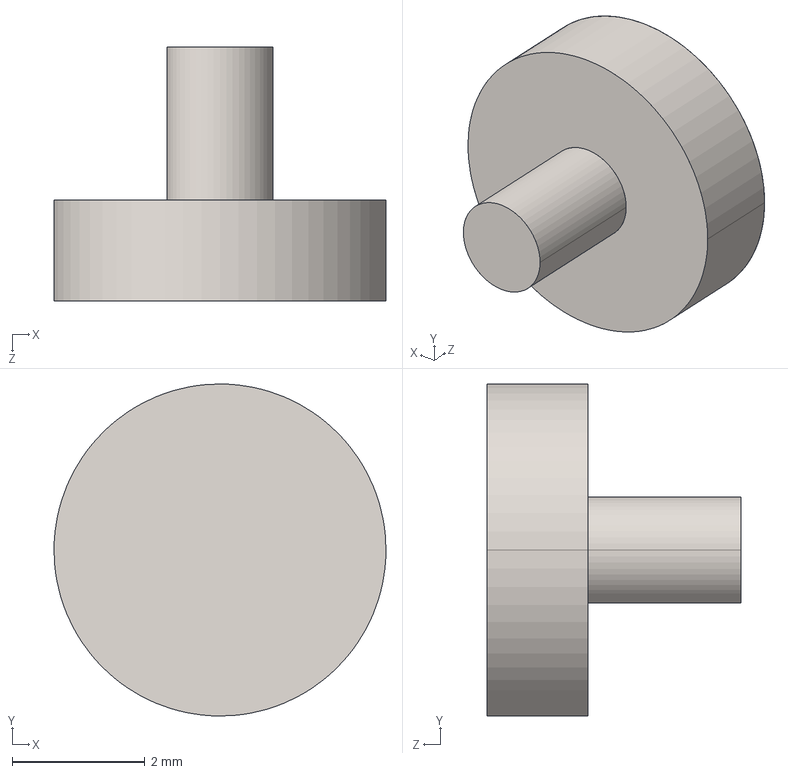
[picture p56: CAD file, 2021-02-01]
MODELO 3D/CAD/.IGES/Complemento_Rodamiento_682-ZZ_2.IGS
5.00 x 5.00 x 3.82 mm
