capaci-thor/Mecanismos/MODELO 3D/CAD/.IGES/Tierra_2.IGS

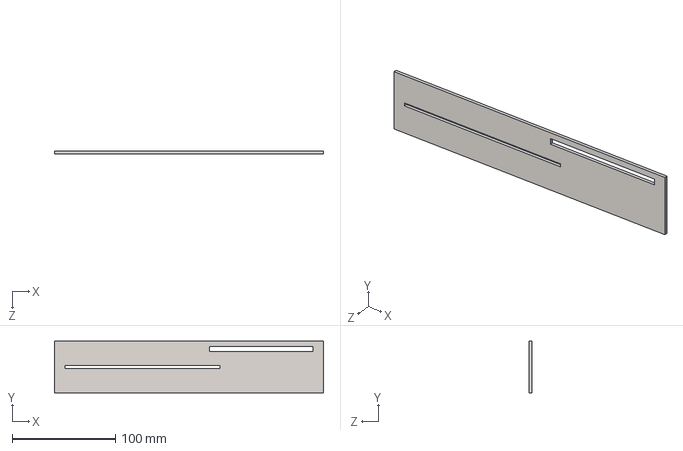
[picture p57: CAD file, 2021-02-01]
MODELO 3D/CAD/.IGES/Tierra_2.IGS
260.0 x 50.0 x 2.66 mm
