capaci-thor/Mecanismos/MODELO 3D/CAD/.IGES/Rodamiento_682-ZZ.IGS

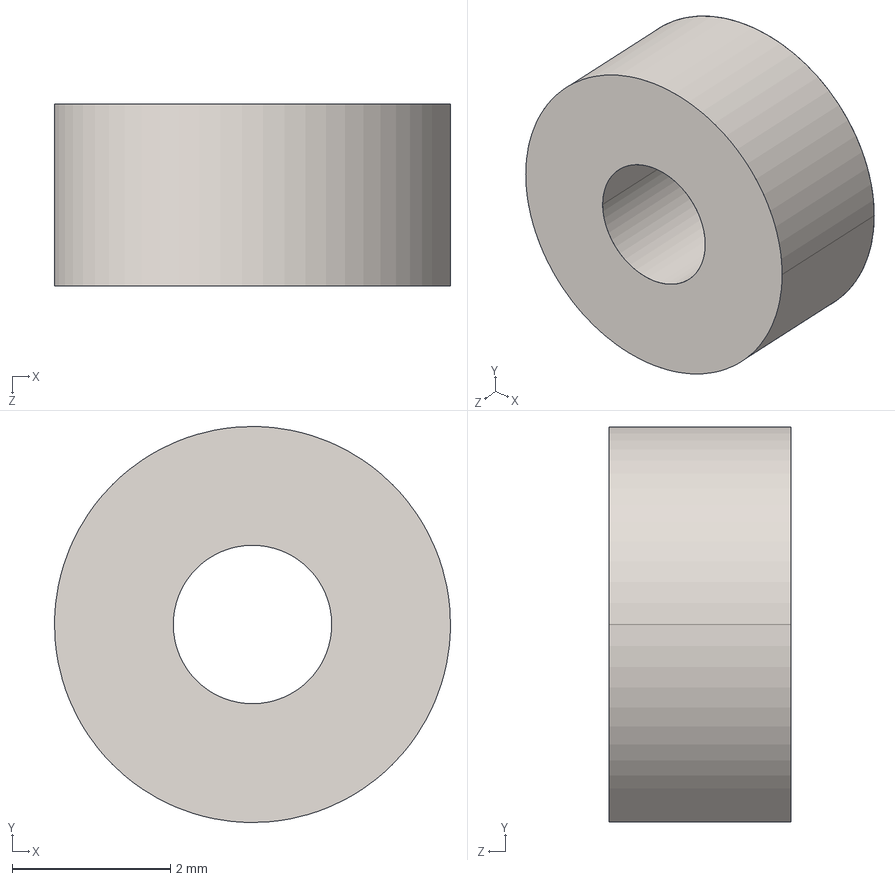
[picture p58: CAD file, 2021-02-01]
MODELO 3D/CAD/.IGES/Rodamiento_682-ZZ.IGS
5.00 x 5.00 x 2.30 mm
