capaci-thor/Mecanismos/MODELO 3D/CAD/.IGES/Tuerca_Mariposa.IGS

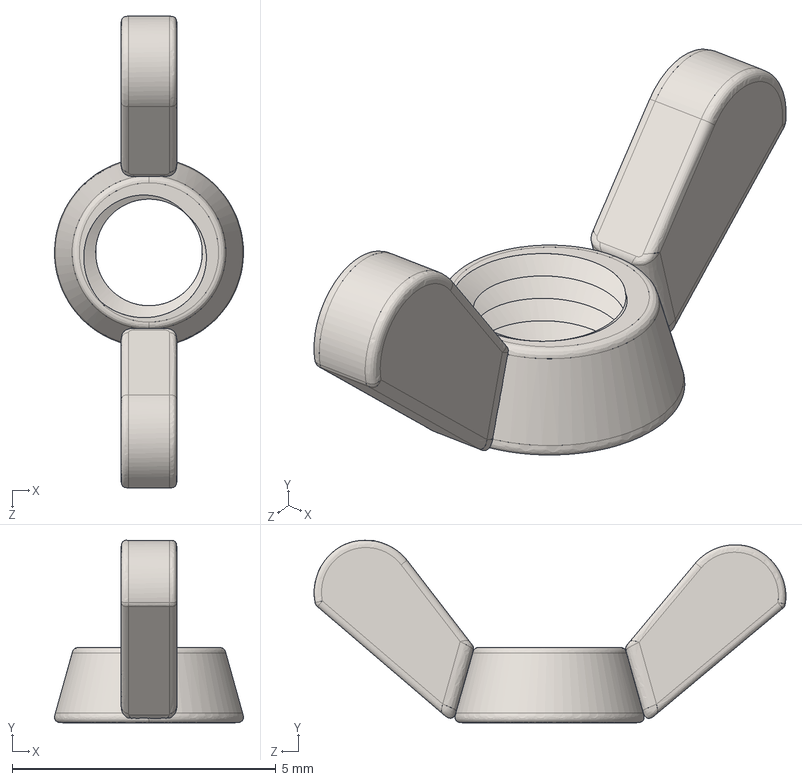
[picture p59: CAD file, 2021-02-01]
MODELO 3D/CAD/.IGES/Tuerca_Mariposa.IGS
3.58 x 3.46 x 8.94 mm
