capaci-thor/Mecanismos/MODELO 3D/CAD/.IGES/Tierra_3.IGS

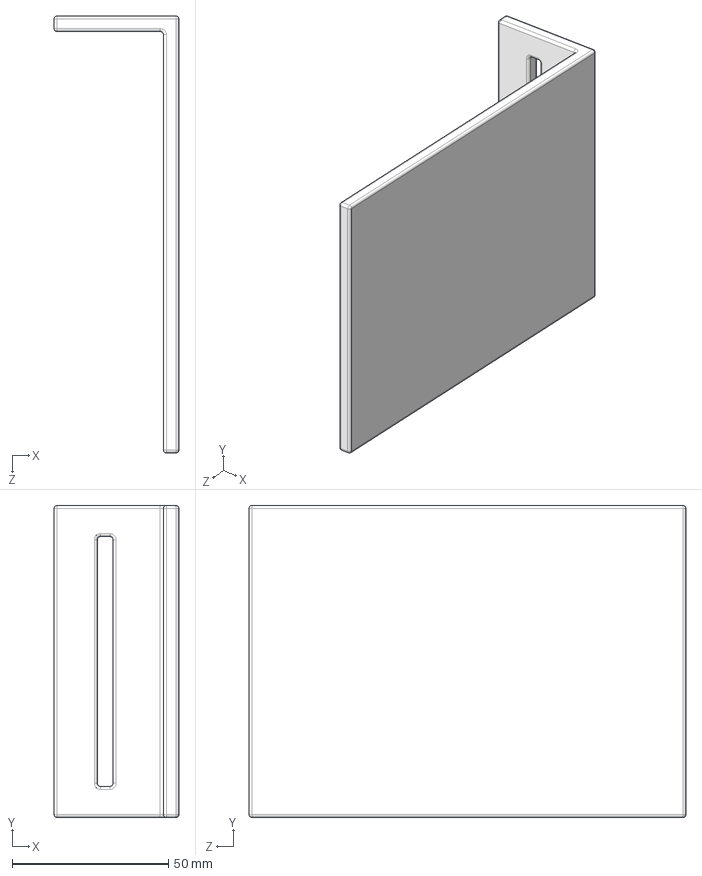
[picture p60: CAD file, 2021-02-01]
MODELO 3D/CAD/.IGES/Tierra_3.IGS
40.0 x 100.0 x 140.0 mm
