capaci-thor/Mecanismos/MODELO 3D/CAD/.IGES/Eslabon_4.IGS

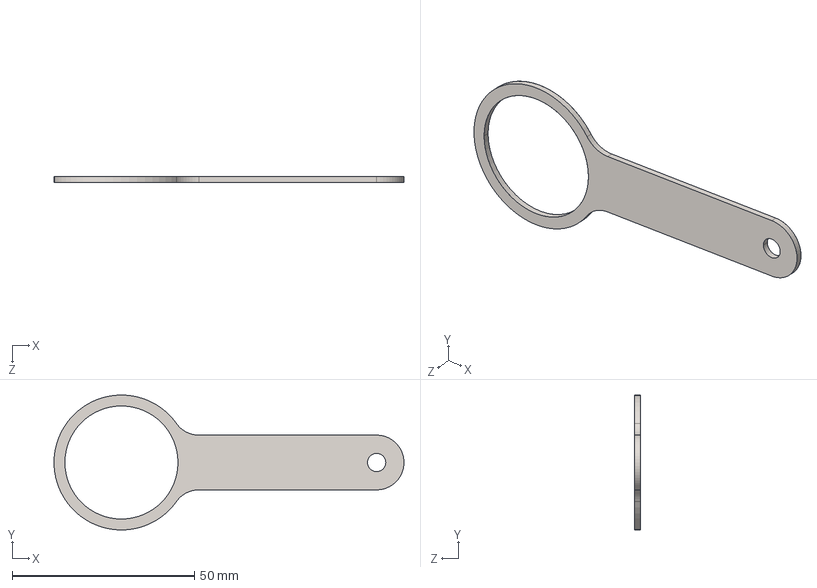
[picture p61: CAD file, 2021-02-01]
MODELO 3D/CAD/.IGES/Eslabon_4.IGS
96.0 x 37.0 x 1.52 mm
