capaci-thor/Mecanismos/MODELO 3D/CAD/.IGES/Eslabon_2.IGS

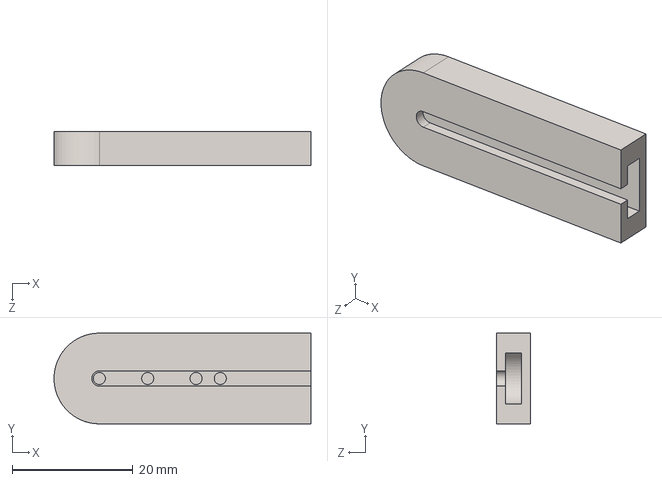
[picture p62: CAD file, 2021-02-01]
MODELO 3D/CAD/.IGES/Eslabon_2.IGS
42.5 x 15.0 x 5.70 mm
