capaci-thor/Mecanismos/MODELO 3D/CAD/.IGES/Eslabon_5.IGS

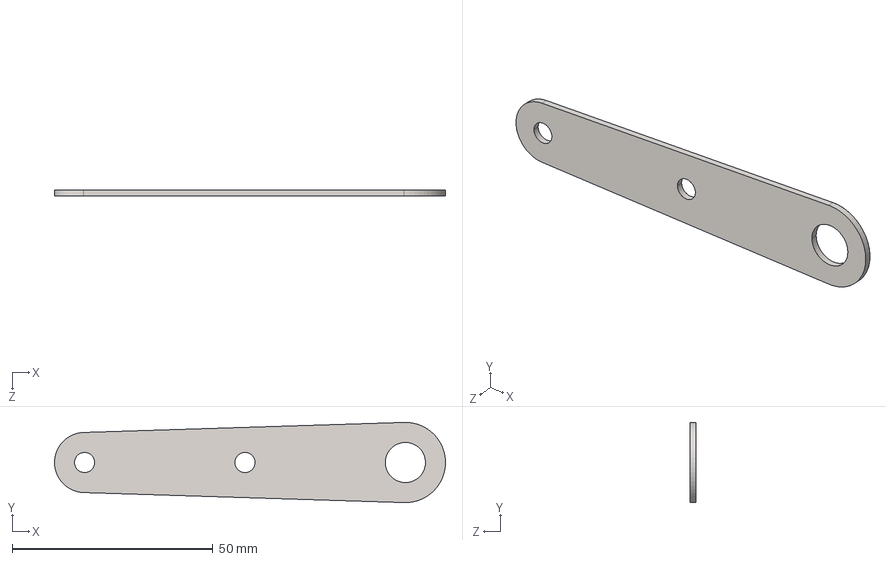
[picture p64: CAD file, 2021-02-01]
MODELO 3D/CAD/.IGES/Eslabon_5.IGS
97.5 x 20.0 x 1.52 mm
