capaci-thor/Mecanismos/MODELO 3D/CAD/.IGES/Eslabon_6.IGS

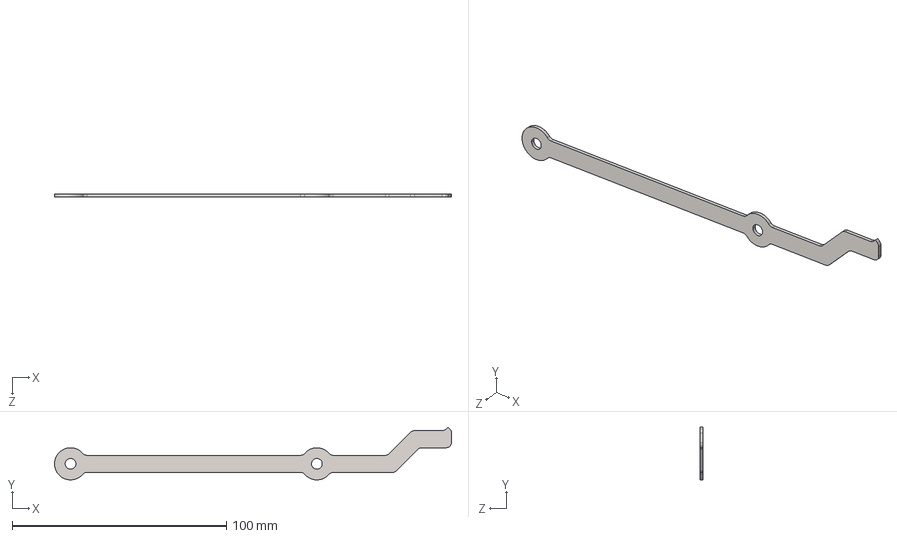
[picture p65: CAD file, 2021-02-01]
MODELO 3D/CAD/.IGES/Eslabon_6.IGS
185.3 x 24.7 x 1.52 mm
