capaci-thor/Mecanismos/MODELO 3D/CAD/.IGES/Eslabon_1.IGS

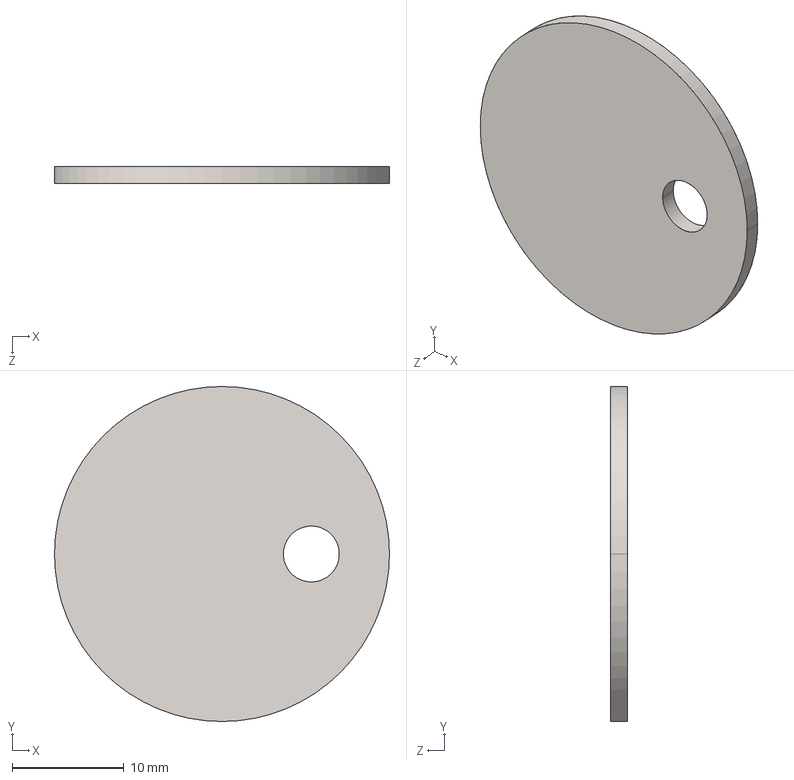
[picture p66: CAD file, 2021-02-01]
MODELO 3D/CAD/.IGES/Eslabon_1.IGS
30.0 x 30.0 x 1.52 mm
