capaci-thor/Mecanismos/MODELO 3D/CAD/.IGES/Complemento_Rodamiento_682-ZZ_1.IGS

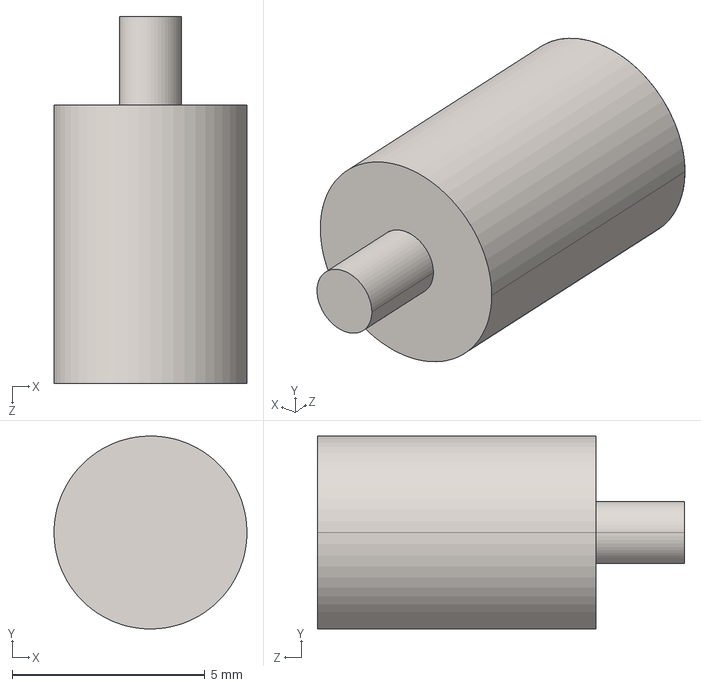
[picture p67: CAD file, 2021-02-01]
MODELO 3D/CAD/.IGES/Complemento_Rodamiento_682-ZZ_1.IGS
5.00 x 5.00 x 9.52 mm
