capaci-thor/Mecanismos/MODELO 3D/CAD/.IGES/Tornillo_M2.IGS

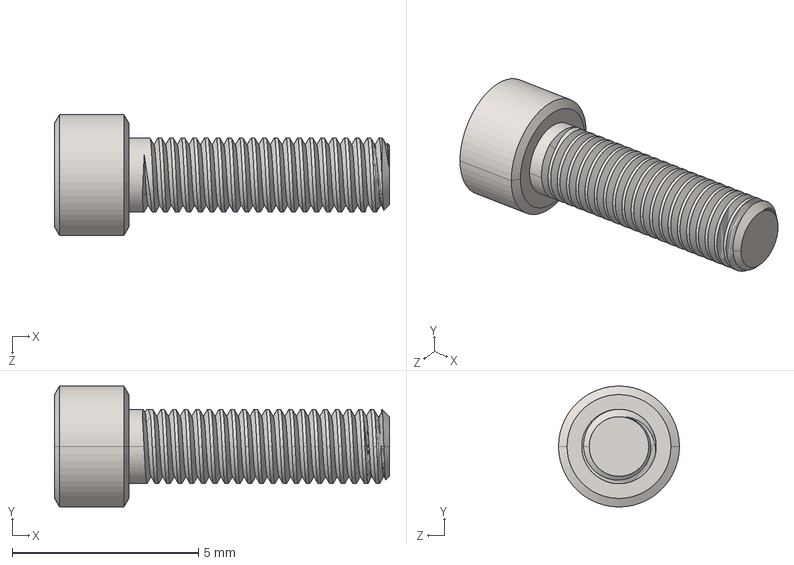
[picture p68: CAD file, 2021-02-01]
MODELO 3D/CAD/.IGES/Tornillo_M2.IGS
9.00 x 3.25 x 3.25 mm
