capaci-thor/Mecanismos/(list of files, cad)

Other CAD files:
MODELO 3D/CAD/.IGES/Ensamble_Mecanismo_13.IGS
MODELO 3D/CAD/IGES/OldVersions/Rover 3 - Verde2.0001.ipt
MODELO 3D/CAD/IGES/Rover 3 - Verde.ipt
MODELO 3D/CAD/IGES/Rover 3 - Verde2.ipt
