capaci-thor/Mecanismos/MODELO 3D/PLANOS/.PDF/Plano_Ensamble.PDF

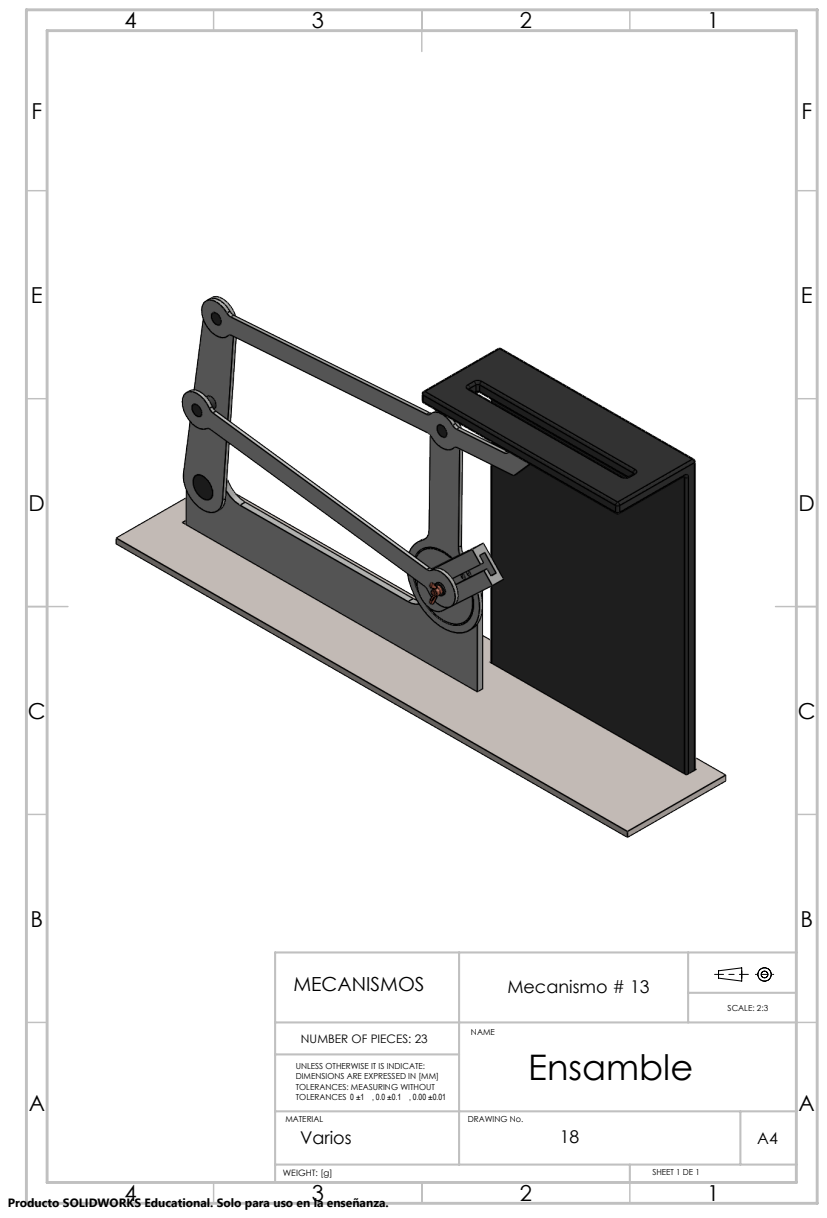
[picture p69: page 1]
SCALE: 2:3

MECANISMOS | Mecanismo # 13

NUMBER OF PIECES: 23 | NAME Ensamble

UNLESS OTHERWISE IT IS INDICATE:
DIMENSIONS ARE EXPRESSED IN [MM]
TOLERANCES: MEASURING WITHOUT
TOLERANCES 0 ±1 , 0.0 ±0.1 , 0.00 ±0.01

MATERIAL Varios | DRAWING No. 18 | A4

WEIGHT: [g] | SHEET 1 DE 1

Producto SOLIDWORKS Educational. Solo para uso en la enseñanza.
