capaci-thor/Mecanismos/MODELO 3D/PLANOS/.PDF/Plano_Arandela_M2.PDF

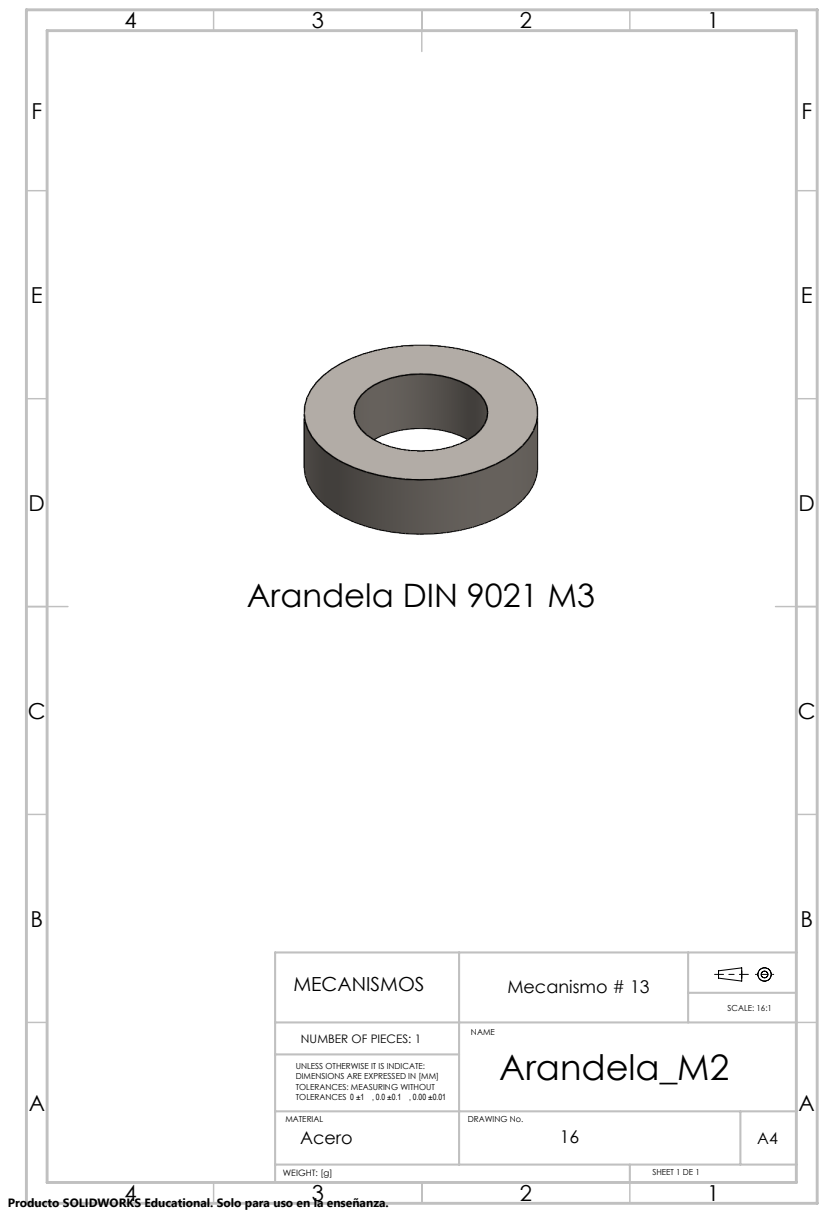
[picture p70: page 1]
Arandela DIN 9021 M3; SCALE: 16:1

MECANISMOS | Mecanismo # 13

NUMBER OF PIECES: 1 | NAME Arandela_M2

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

MATERIAL Acero | DRAWING No. 16 | A4

WEIGHT: [g] | SHEET 1 DE 1

Producto SOLIDWORKS Educational. Solo para uso en la enseñanza.
