capaci-thor/Mecanismos/MODELO 3D/PLANOS/.PDF/Plano_Complemento_Rodamiento_623-2RS.PDF

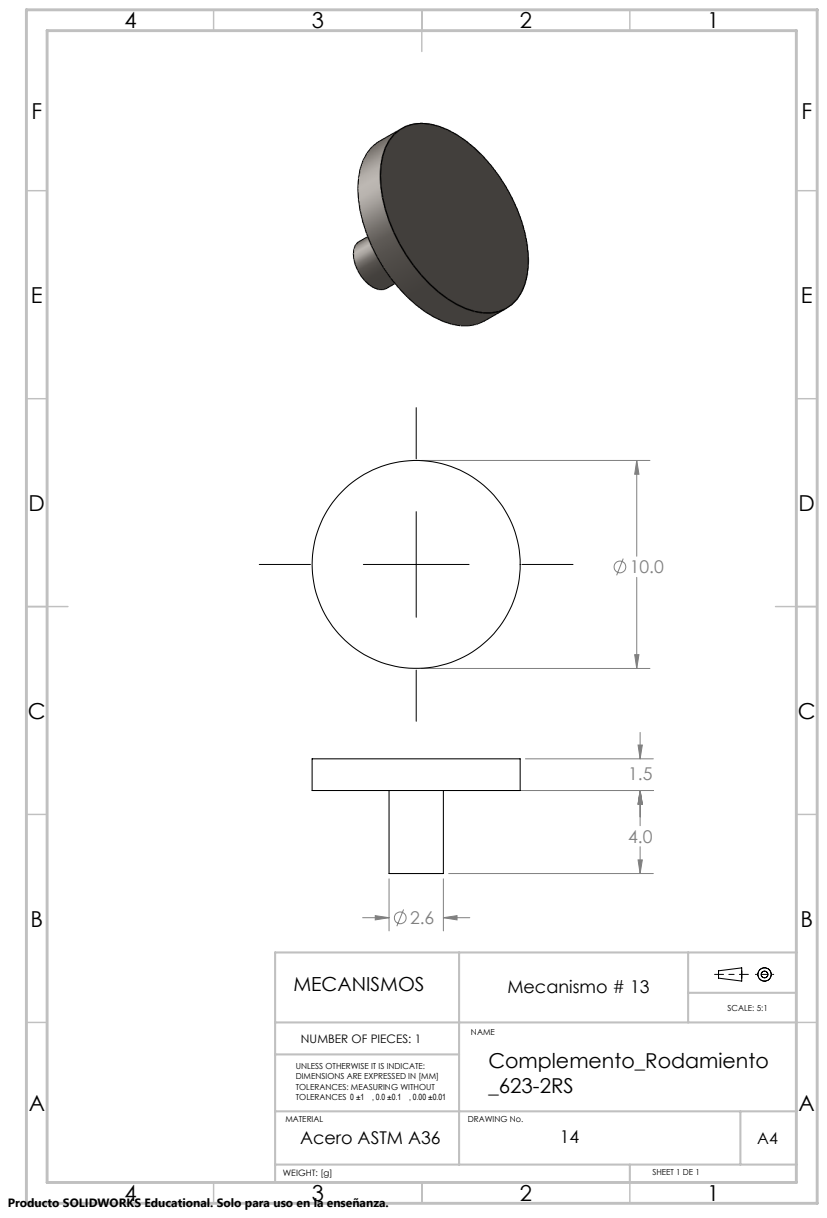
[picture p71: page 1]
SCALE: 5:1

MECANISMOS | Mecanismo # 13

NUMBER OF PIECES: 1 | NAME Complemento_Rodamiento _623-2RS

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

MATERIAL Acero ASTM A36 | DRAWING No. 14 | A4

WEIGHT: [g] | SHEET 1 DE 1

Producto SOLIDWORKS Educational. Solo para uso en la enseñanza.
