capaci-thor/Mecanismos/MODELO 3D/PLANOS/.PDF/Plano_Complemento_Rodamiento_682-ZZ_1.PDF

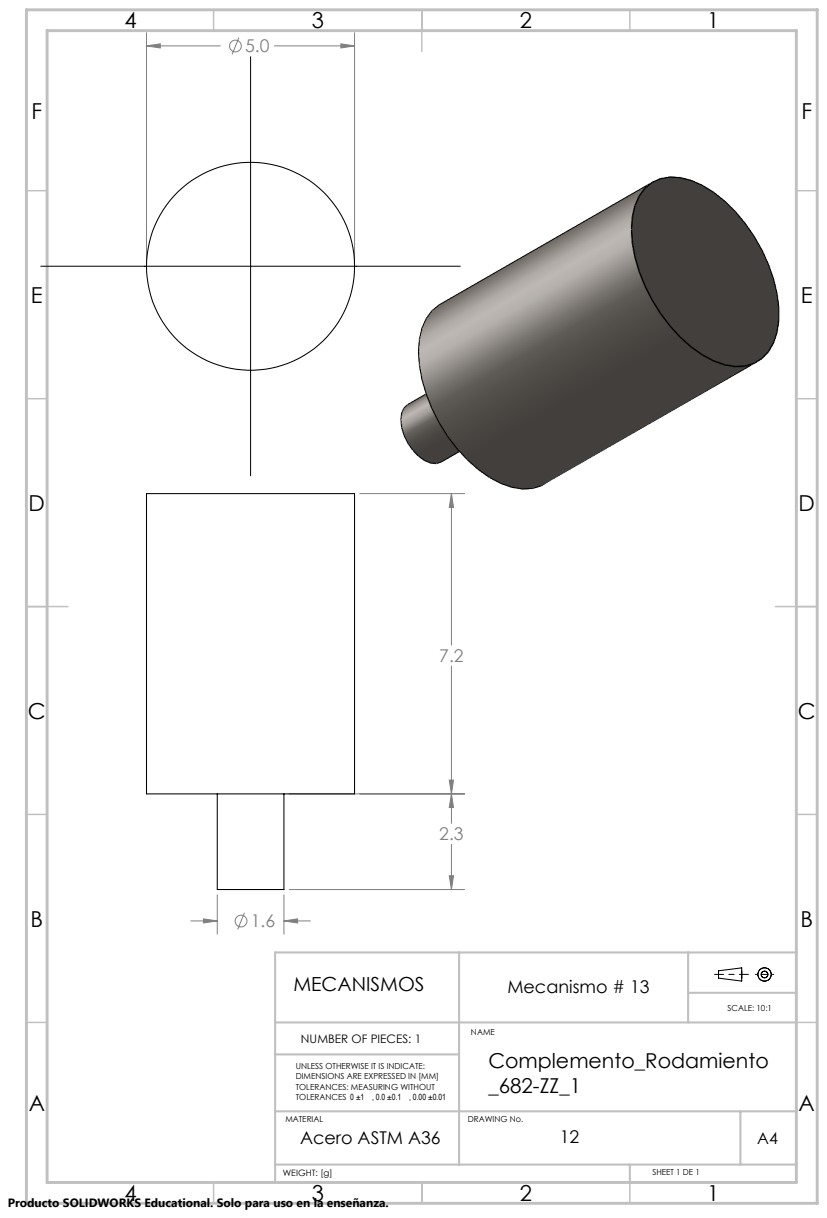
[picture p72: page 1]
SCALE: 10:1

MECANISMOS | Mecanismo # 13

NUMBER OF PIECES: 1 | NAME Complemento_Rodamiento _682-ZZ_1

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

MATERIAL Acero ASTM A36 | DRAWING No. 12 | A4

WEIGHT: [g] | SHEET 1 DE 1

Producto SOLIDWORKS Educational. Solo para uso en la enseñanza.
