capaci-thor/Mecanismos/MODELO 3D/PLANOS/.PDF/Plano_Eslabon_2.PDF

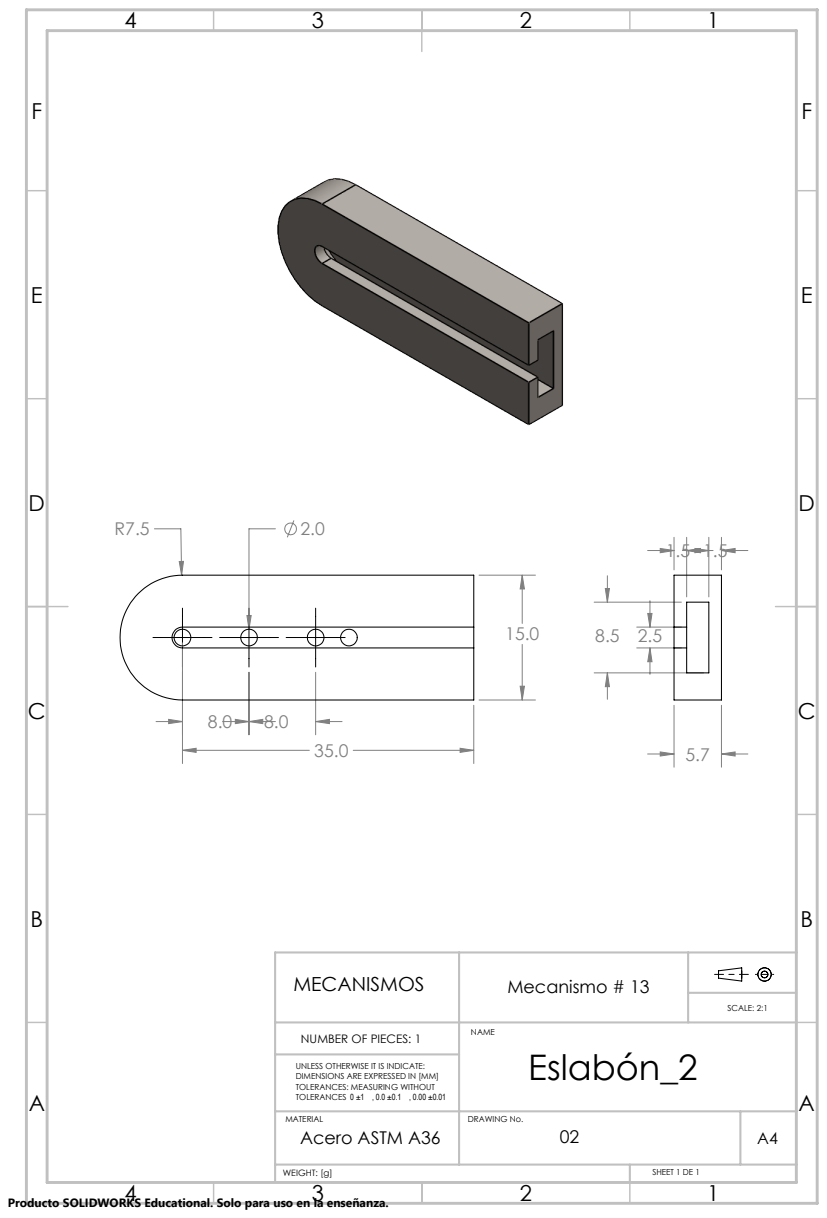
[picture p74: page 1]
SCALE: 2:1

MECANISMOS | Mecanismo # 13

NUMBER OF PIECES: 1 | NAME Eslabón_2

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

MATERIAL Acero ASTM A36 | DRAWING No. 02 | A4

WEIGHT: [g] | SHEET 1 DE 1

Producto SOLIDWORKS Educational. Solo para uso en la enseñanza.
