capaci-thor/Mecanismos/MODELO 3D/PLANOS/.PDF/Plano_Rodamiento_623-2RS.PDF

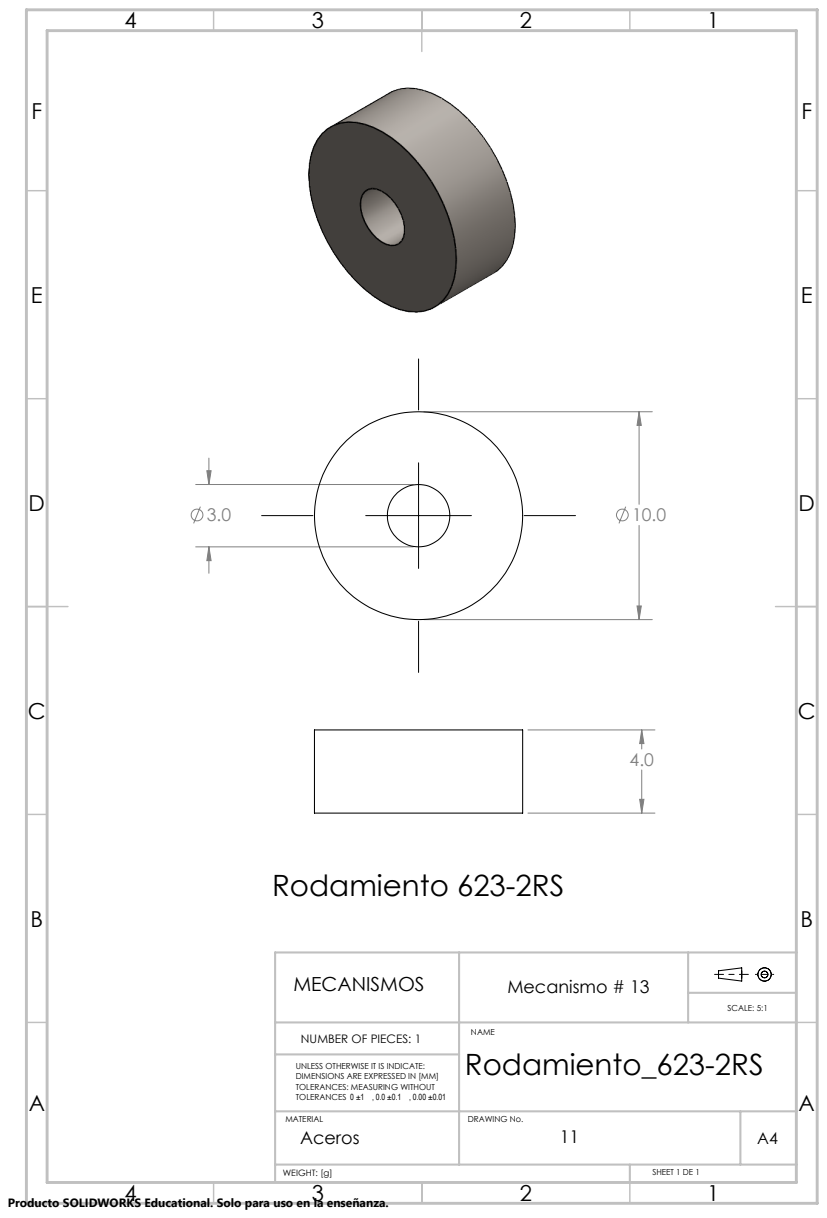
[picture p79: page 1]
Rodamiento 623-2RS; SCALE: 5:1

MECANISMOS | Mecanismo # 13

NUMBER OF PIECES: 1 | NAME Rodamiento_623-2RS

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

MATERIAL Aceros | DRAWING No. 11 | A4

WEIGHT: [g] | SHEET 1 DE 1

Producto SOLIDWORKS Educational. Solo para uso en la enseñanza.
