capaci-thor/Mecanismos/MODELO 3D/PLANOS/.PDF/Plano_Rodamiento_682-ZZ.PDF

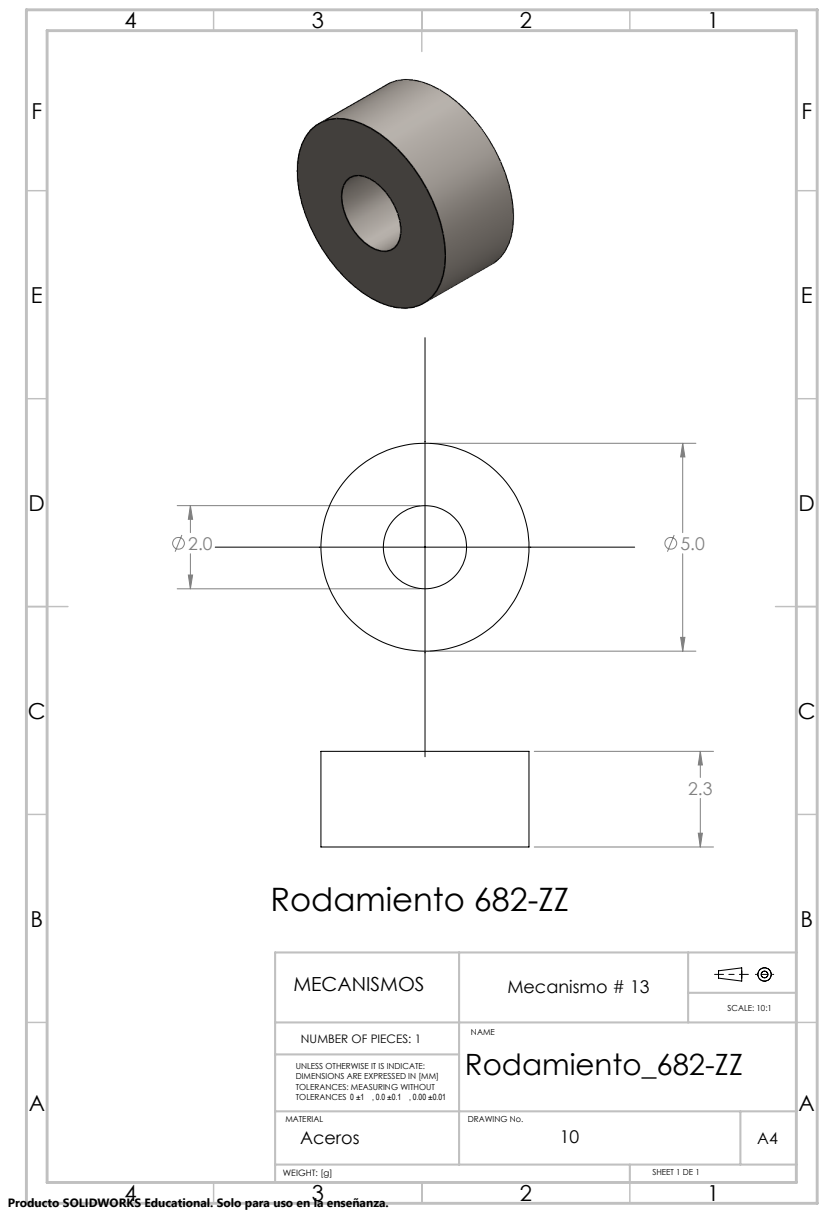
[picture p80: page 1]
Rodamiento 682-ZZ; SCALE: 10:1

MECANISMOS | Mecanismo # 13

NUMBER OF PIECES: 1 | NAME Rodamiento_682-ZZ

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

MATERIAL Aceros | DRAWING No. 10 | A4

WEIGHT: [g] | SHEET 1 DE 1

Producto SOLIDWORKS Educational. Solo para uso en la enseñanza.
