capaci-thor/Mecanismos/MODELO 3D/PLANOS/.PDF/Plano_Tierra_3.PDF

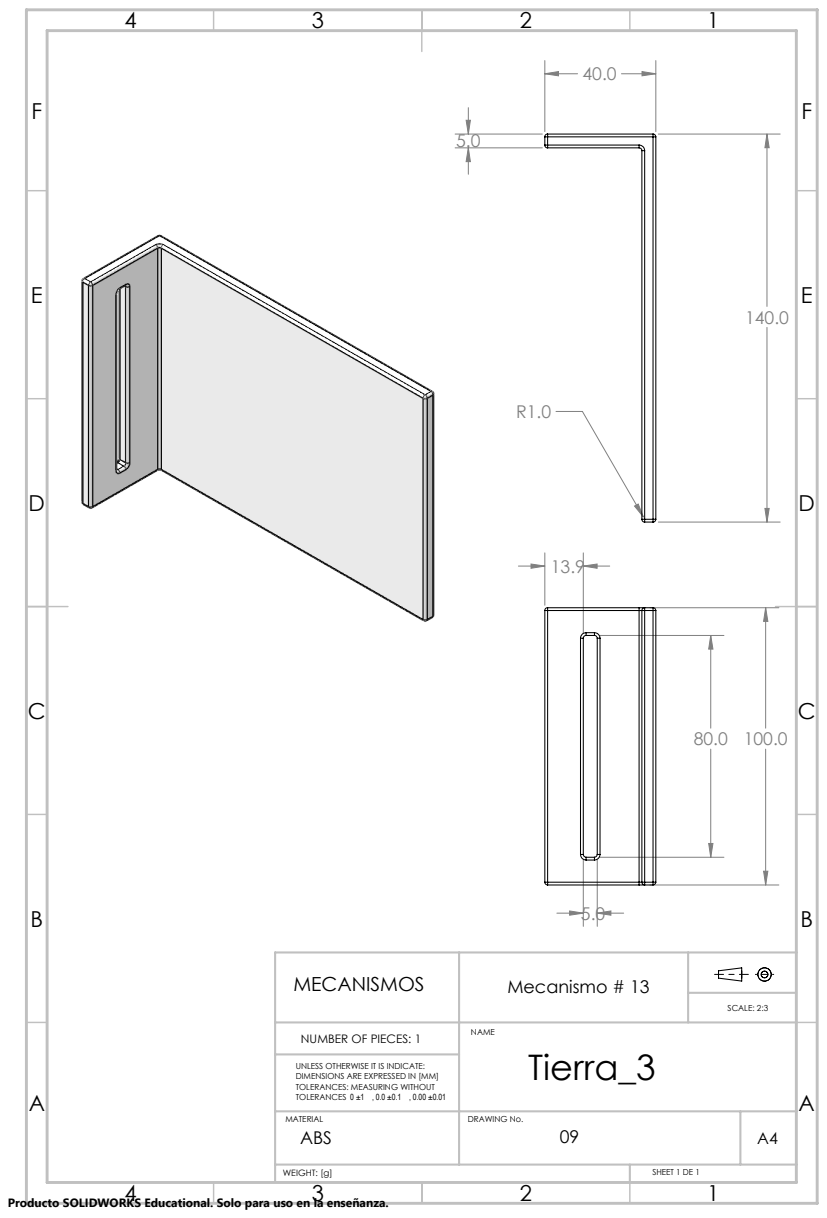
[picture p83: page 1]
SCALE: 2:3

MECANISMOS | Mecanismo # 13

NUMBER OF PIECES: 1 | NAME Tierra_3

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

MATERIAL ABS | DRAWING No. 09 | A4

WEIGHT: [g] | SHEET 1 DE 1

Producto SOLIDWORKS Educational. Solo para uso en la enseñanza.
