capaci-thor/Mecanismos/MODELO 3D/PLANOS/.PDF/Plano_Explosivo.PDF

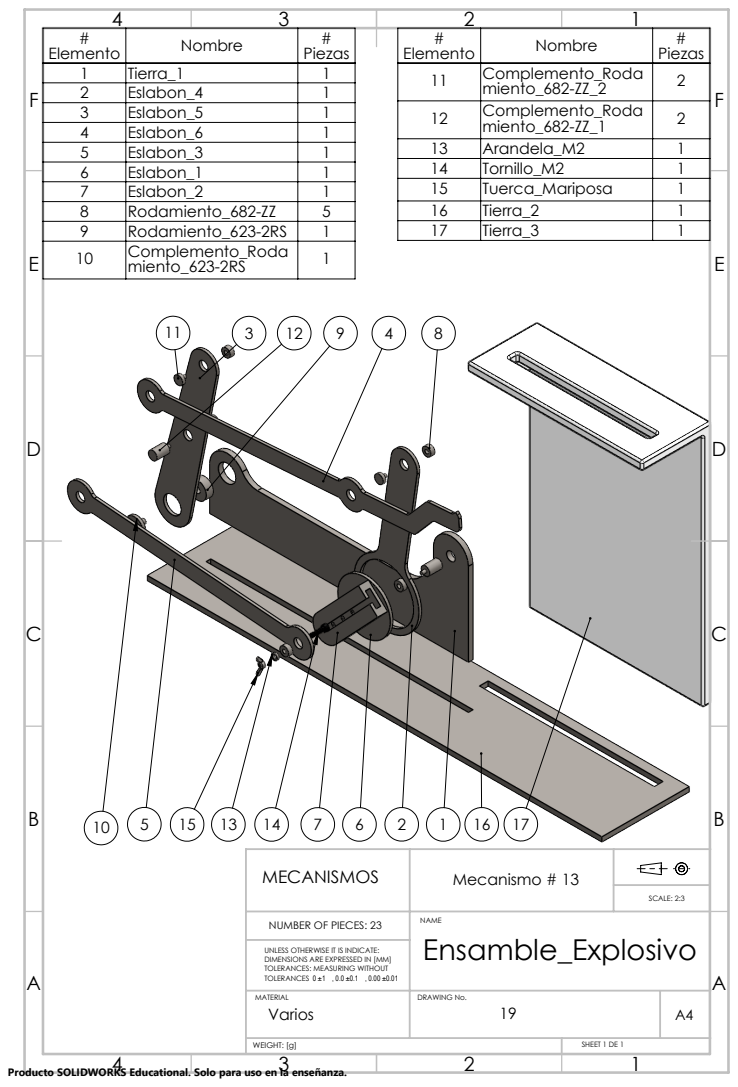
[picture p85: page 1]
SCALE: 2:3

Elemento # | Nombre | # Piezas | | Elemento # | Nombre | # Piezas
1 | Tierra_1 | 1 | | 11 | Complemento_Roda miento_682-ZZ_2 | 2
2 | Eslabon_4 | 1
3 | Eslabon_5 | 1 | | 12 | Complemento_Roda miento_682-ZZ_1 | 2
4 | Eslabon_6 | 1
5 | Eslabon_3 | 1
6 | Eslabon_1 | 1
7 | Eslabon_2 | 1
8 | Rodamiento_682-ZZ | 5 | | 16 | Tierra_2 | 1
9 | Rodamiento_623-2RS | 1 | | 17 | Tierra_3 | 1
10 | Complemento_Roda miento_623-2RS | 1

13 | Arandela_M2 | 1
14 | Tornillo_M2 | 1
15 | Tuerca_Mariposa | 1

MECANISMOS | Mecanismo # 13

NUMBER OF PIECES: 23 | NAME Ensamble_Explosivo

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

MATERIAL Varios | DRAWING No. 19 | A4

WEIGHT: [g] | SHEET 1 DE 1

Producto SOLIDWORKS Educational. Solo para uso en la enseñanza.
