capaci-thor/Mecanismos/MODELO 3D/PLANOS/.PDF/Plano_Tuerca_Mariposa_M2.PDF

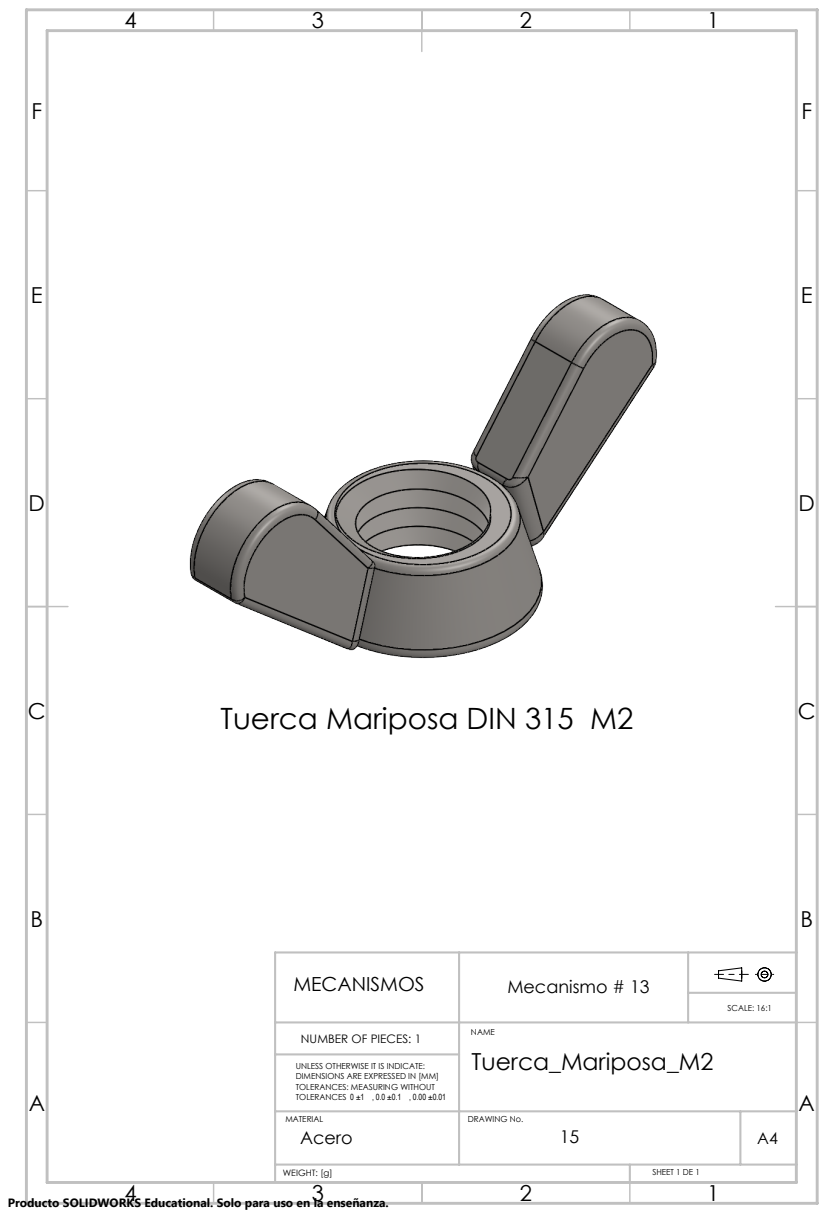
[picture p86: page 1]
SCALE: 16:1

Tuerca Mariposa DIN 315 M2

MECANISMOS | Mecanismo # 13

NUMBER OF PIECES: 1 | NAME Tuerca_Mariposa_M2

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

MATERIAL Acero | DRAWING No. 15 | A4

WEIGHT: [g] | SHEET 1 DE 1

Producto SOLIDWORKS Educational. Solo para uso en la enseñanza.
