capaci-thor/Mecanismos/(commit log)

2020-06-13 plannteamiento del probelmas mal. Corregir lazos y vectores
2020-06-13 Plantilla para solución inicial, falta agregar dimensiones
2020-06-13 Mecanismo que se debe realizar
2020-06-13 Cálculo de los grados de libertad
2020-06-13 Planteamiento de vectores, error al plantear lazos. LV 3 inecesario. Y theta 2 se puede basar en theta 1
2020-06-13 Faltan agregar longitudes de eslabones, plantear posicion inicial con ángulos de valores semilla
2020-06-13 Archivo con escalas de eslabones
    [MEDIDAS_ESCALA.xlsx]
2020-06-13 MEdidas redondeaas
    [MEDIDAS_ESCALA.xlsx]
2020-06-13 Error de singularidad
2020-06-14 Imagenes de los lazos vectoriales
2020-06-14 Graficas de posiciones
2020-06-14 Editable de los vectores
2020-06-14 Mecanismo al que se le debe dar solución
2021-02-01 Terminado el proyecto final
    [Arandela_M2.IGS, Complemento_Rodamiento_623-2RS.IGS, Complemento_Rodamiento_682-ZZ_1.IGS, Complemento_Rodamiento_682-ZZ_2.IGS, Ensamble_Mecanismo_13.IGS, Ensamble_Parte_Mecanismo_13.IGS, Eslabon_1.IGS, Eslabon_2.IGS]
2021-02-01 Organizado y retorado de documentos no utilizados
    [MEDIDAS_ESCALA.xlsx]
